IntergalacticMicrosystems/pico_v9k/hardware/rev2/v9k_dma_rev2.routed.png

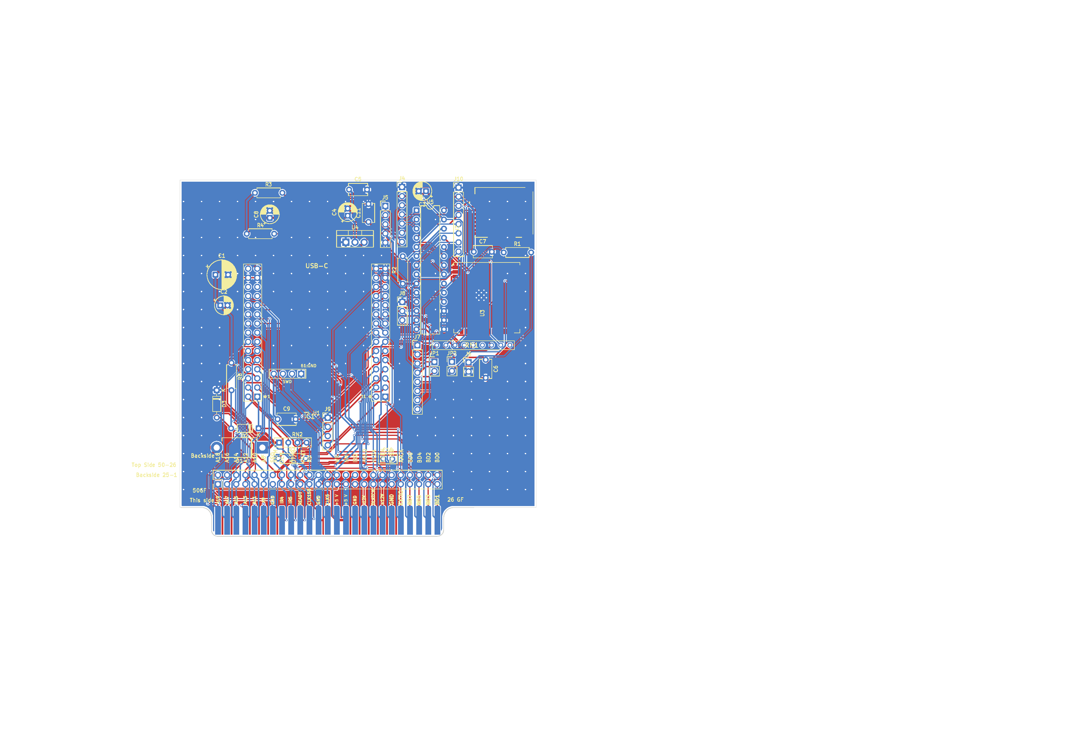
hardware/rev2/v9k_dma_rev2.routed.png
