IntergalacticMicrosystems/pico_v9k/hardware/rev2/v9k_dma_rev2.pdf

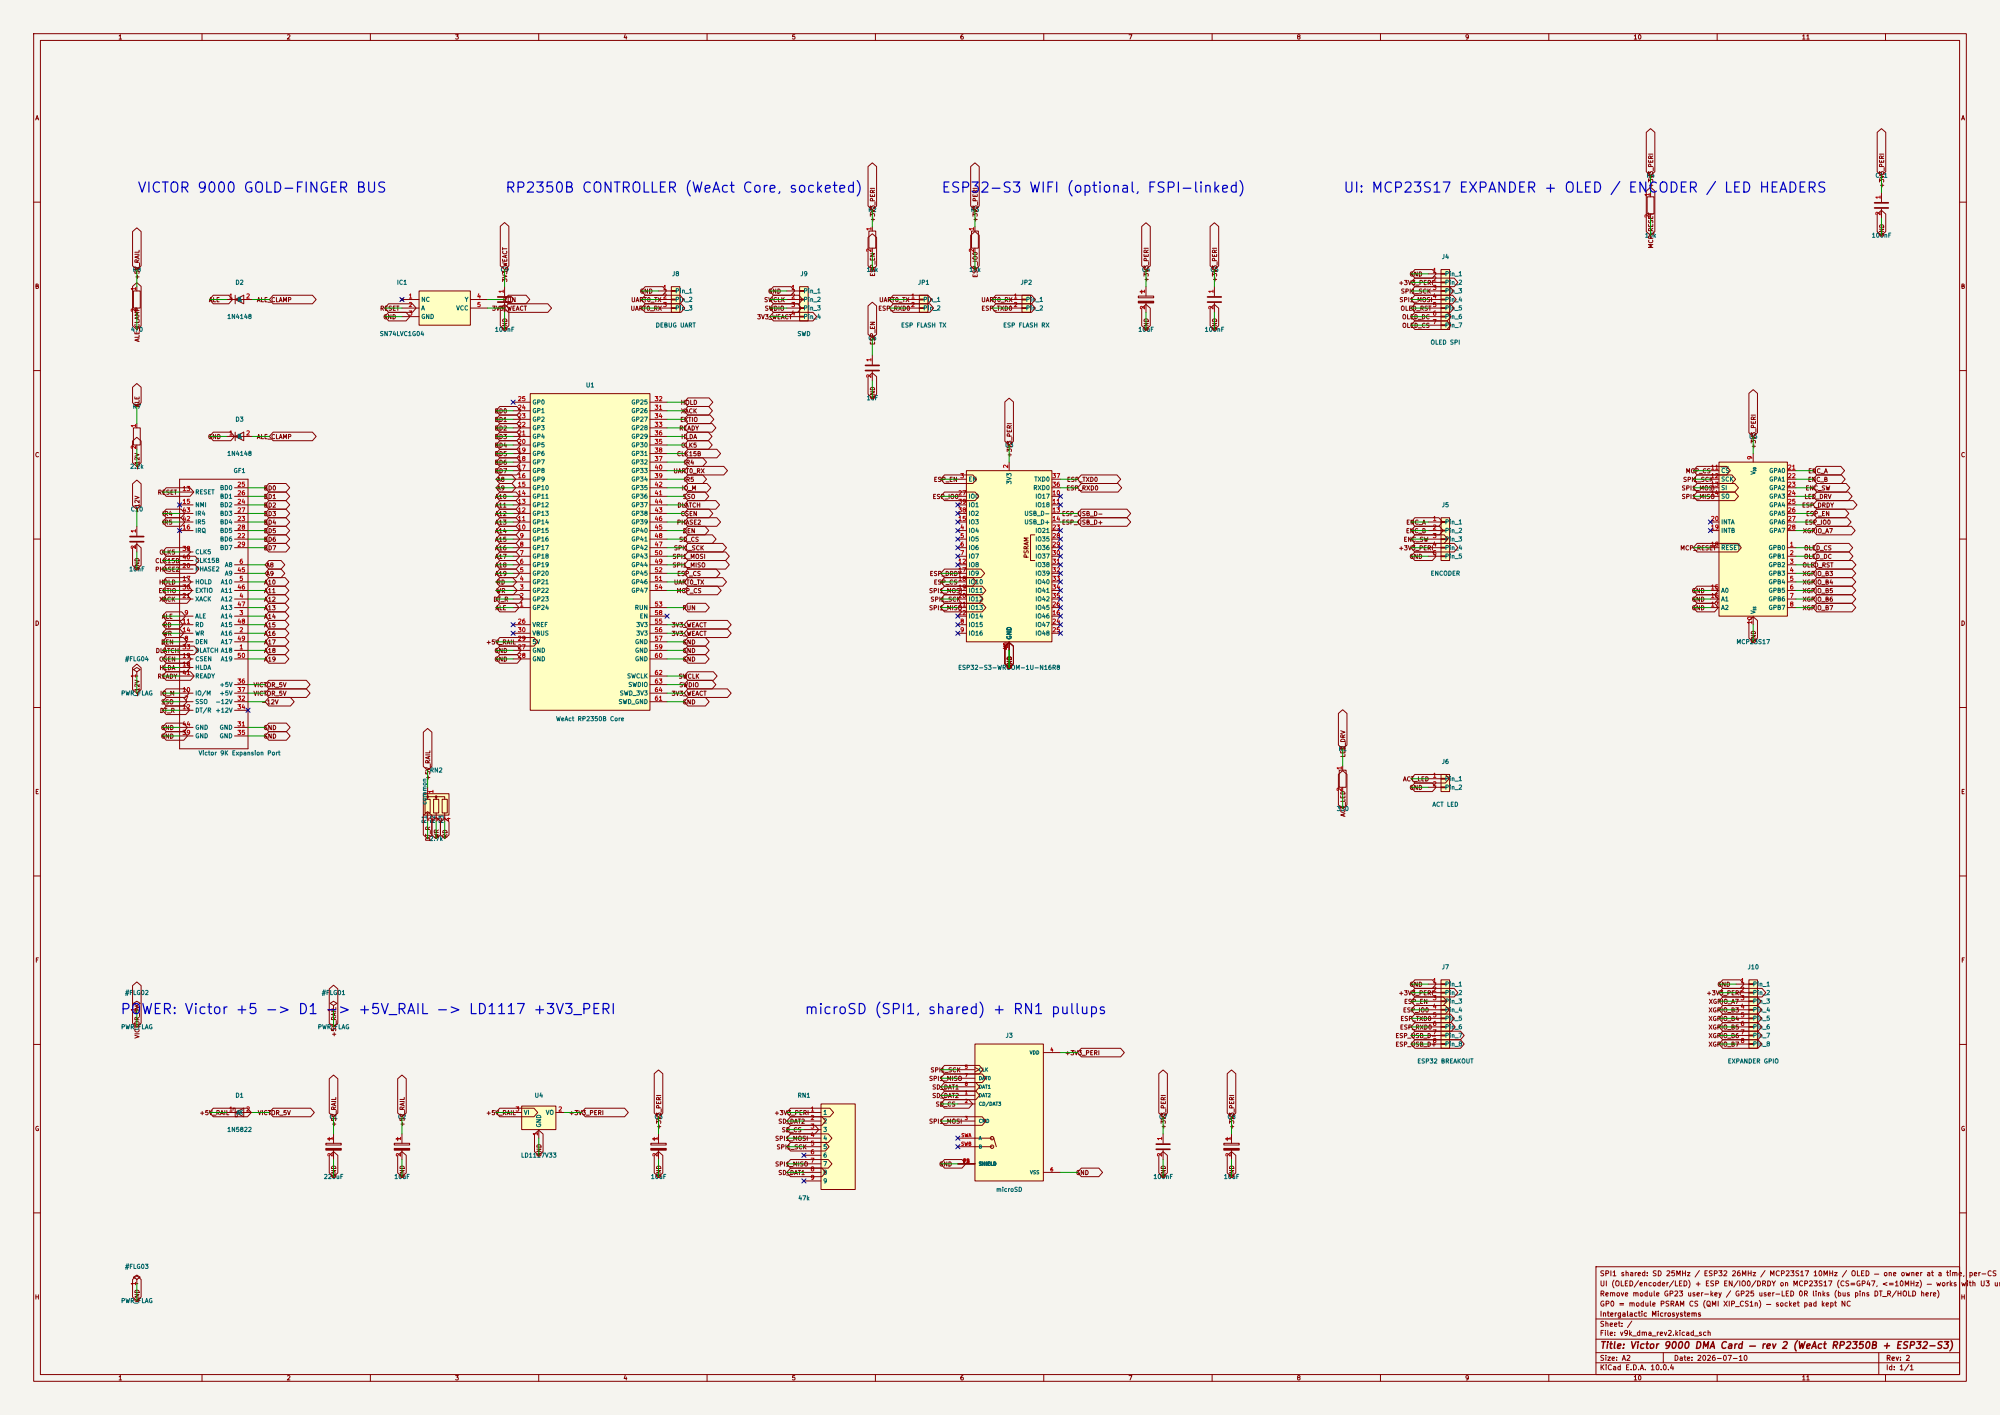
[picture p2: page 1]

IRQ 16 HOLD 17 HLDA 18 CSEN 19 PHASE2 20
HLDA READY PHASE2 CLK15B

SPI1 shared: SD 25MHz / ESP32 26MHz / MCP23S17 10MHz / OLED — one owner at a time, per-CS baud
Remove module GP23 user-key / GP25 user-LED 0R links (bus pins DT_R/HOLD here)
GP0 = module PSRAM CS (QMI XIP_CS1n) — socket pad kept NC
Intergalactic Microsystems
Sheet: /
File: v9k_dma_rev2.kicad_sch
Title: Victor 9000 DMA Card — rev 2 (WeAct RP2350B + ESP32-S3)

Size: A2 | Rev: 2
KiCad E.D.A. 10.0.4 | Id: 1/1
