IntergalacticMicrosystems/pico_v9k/hardware/rev2/v9k_dma_rev2.kicad_pcb

## KiCad design hardware/rev2/v9k_dma_rev2.kicad_pcb (2026-07-11)

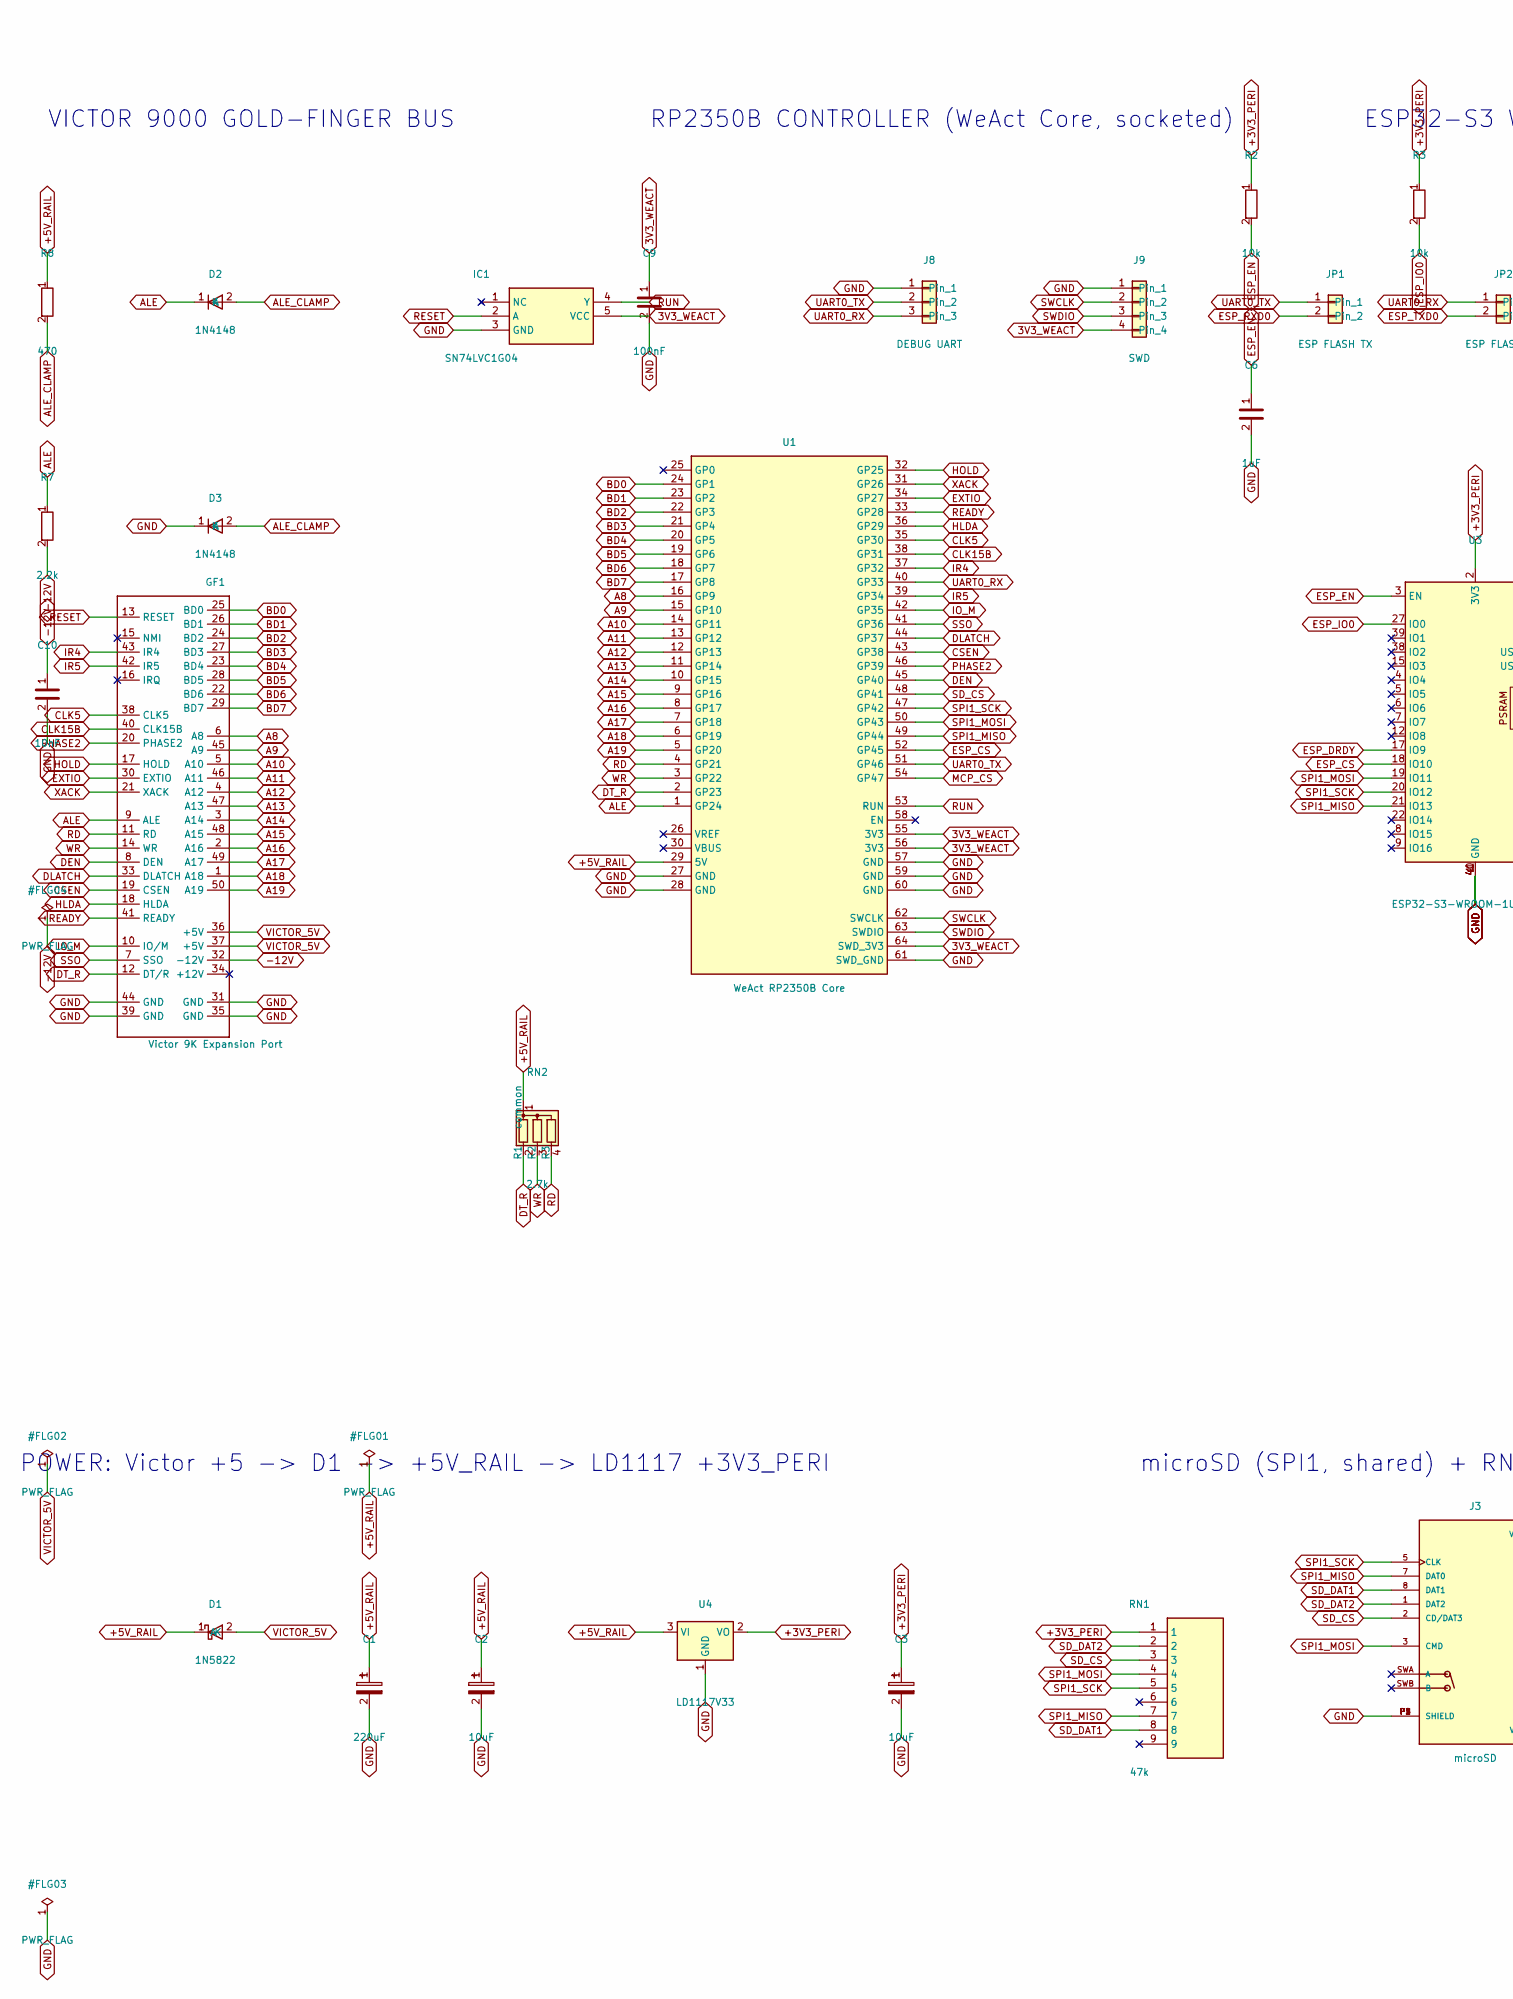
[picture p3: schematic v9k_dma_rev2.kicad_sch, Victor 9000 DMA Card — rev 2 (WeAct RP2350B + ESP32-S3), part in row 1, column 1]

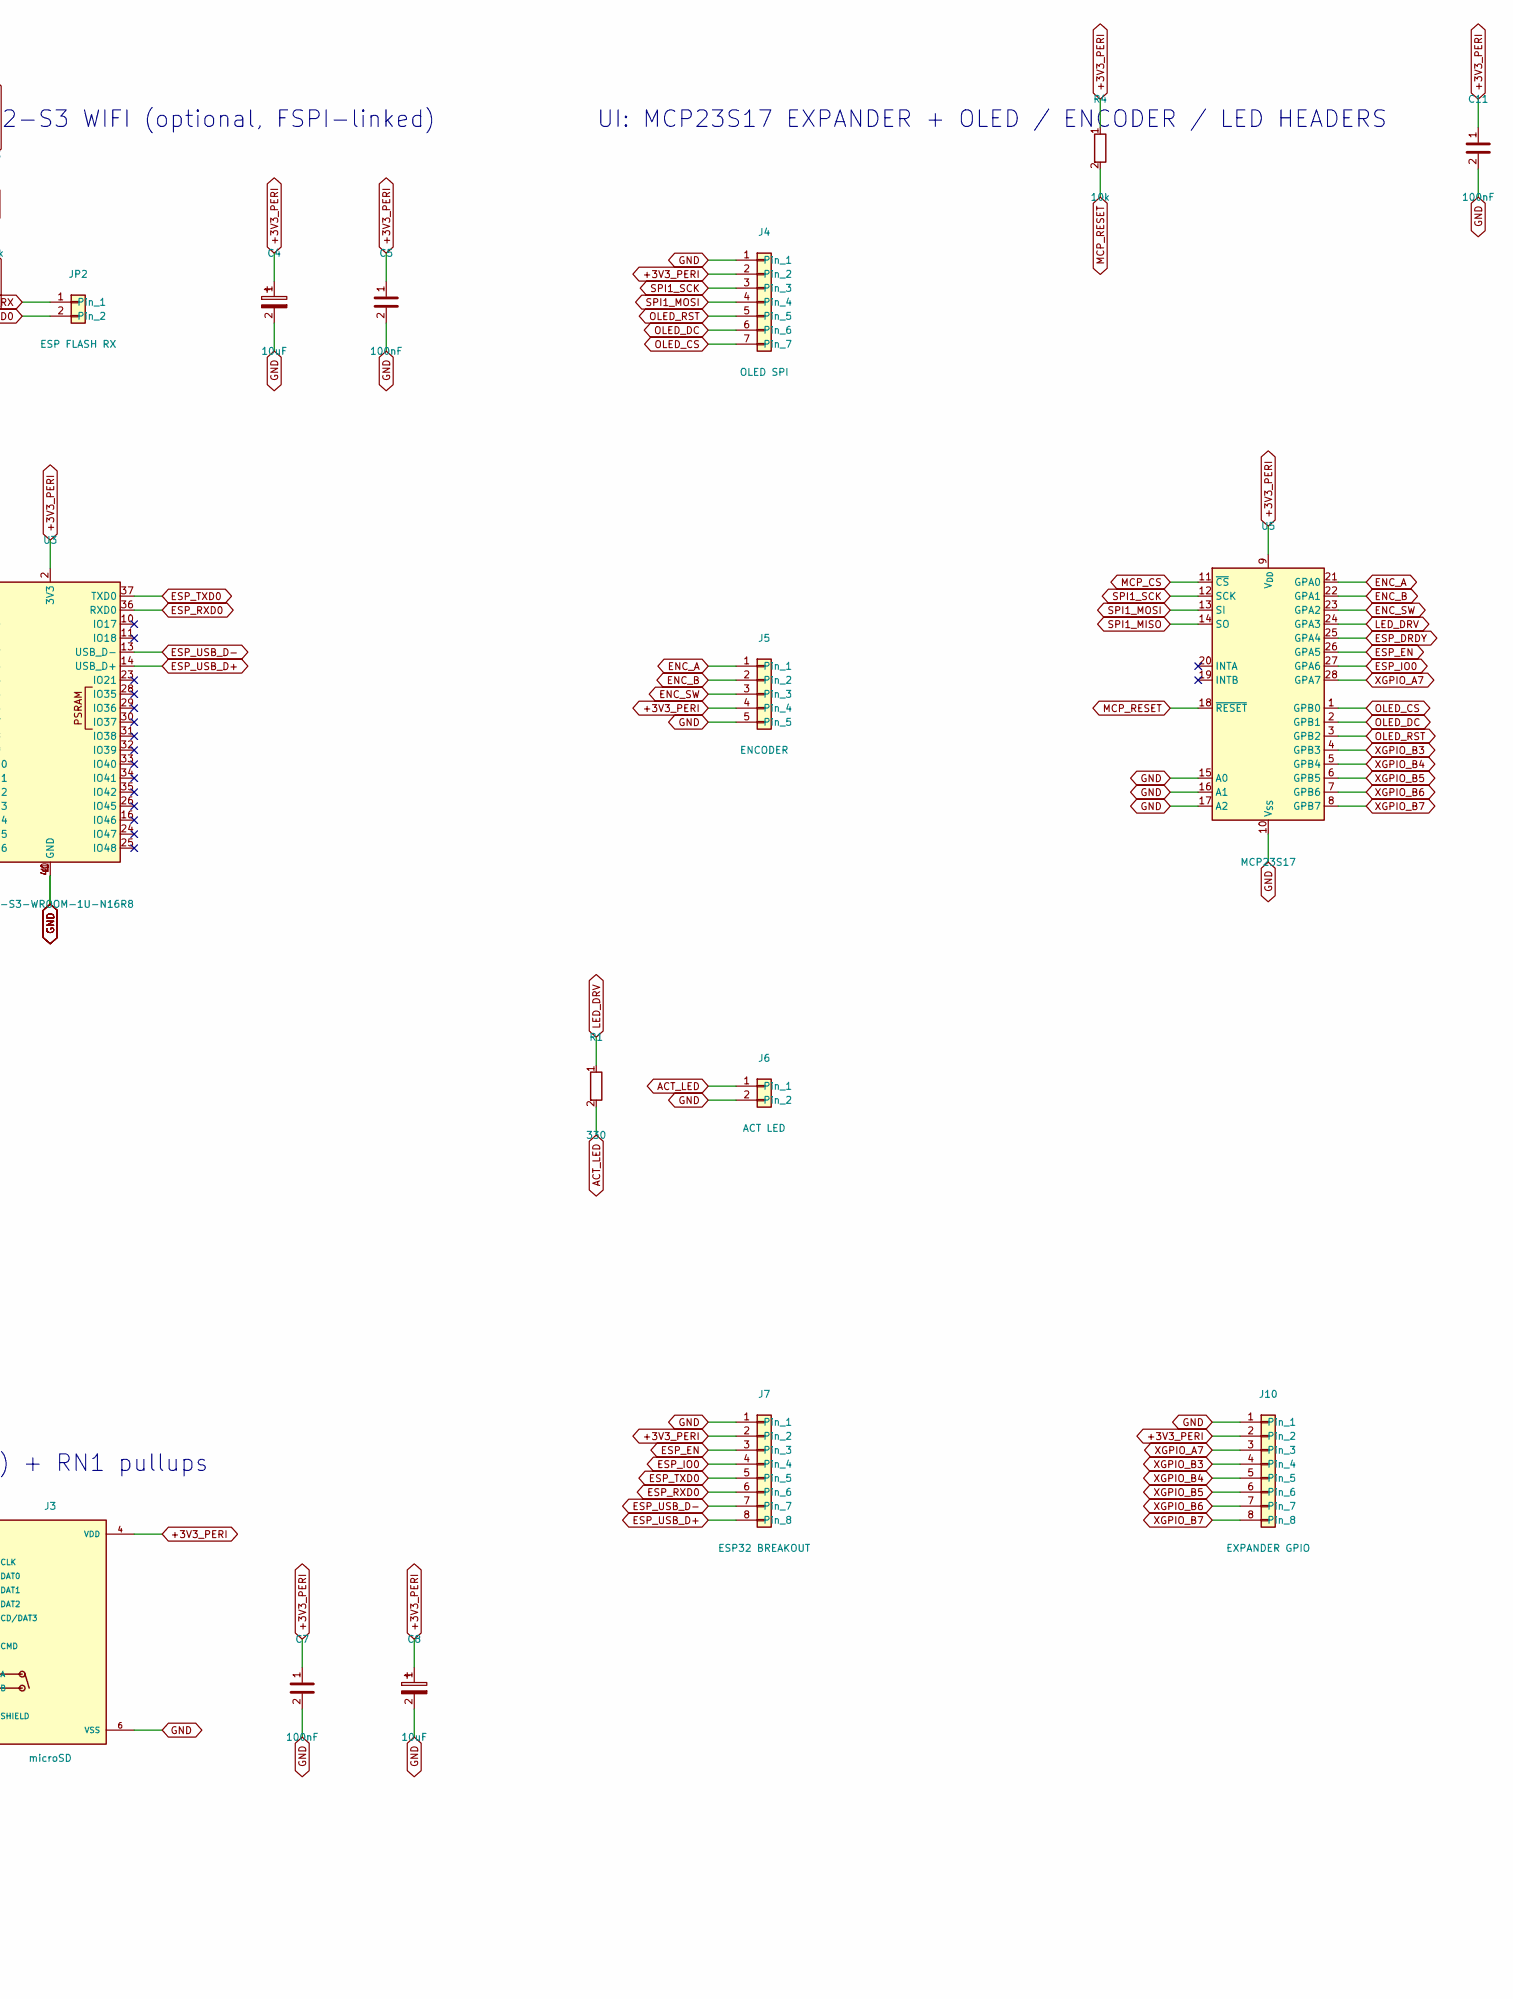
[picture p4: schematic v9k_dma_rev2.kicad_sch, Victor 9000 DMA Card — rev 2 (WeAct RP2350B + ESP32-S3), part in row 1, column 2]

Parts:
C1: 220uF; CP_Radial_D8.0mm_P3.50mm; MPN ESE227M025AG3AA
C2, C3, C4, C8: 10uF; CP_Radial_D5.0mm_P2.00mm; MPN 50YXJ10M5X11
C5, C7, C9, C11: 100nF; C_Disc_D5.1mm_W3.2mm_P5.00mm; MPN RD20B104K500A5HAND
C6: 1uF; C_Disc_D5.1mm_W3.2mm_P5.00mm; MPN SR305E105ZARTR1
C10: 10nF; C_Disc_D5.0mm_W2.5mm_P2.50mm; MPN C315C103K5R5TA
D1: 1N5822; D_DO-201AD_P12.70mm_Horizontal; MPN 1N5822-TP
D2, D3: 1N4148; D_DO-35_SOD27_P7.62mm_Horizontal; MPN 1N4148
GF1: Victor 9K Expansion Port; Victor_Gold_Fingers_3
IC1: SN74LVC1G04; SOT65P210X110-5N; MPN SN74LVC1G04DCKR
J3: microSD; HRS_DM3AT-SF-PEJM5; MPN DM3AT-SF-PEJM5
J4: OLED SPI; PinHeader_1x07_P2.54mm_Vertical; MPN PREC040SAAN-RC
J5: ENCODER; PinHeader_1x05_P2.54mm_Vertical; MPN PREC040SAAN-RC
J6: ACT LED; PinHeader_1x02_P2.54mm_Vertical; MPN PREC040SAAN-RC
J7: ESP32 BREAKOUT; PinHeader_1x08_P2.54mm_Vertical; MPN PREC040SAAN-RC
J8: DEBUG UART; PinHeader_1x03_P2.54mm_Vertical; MPN PREC040SAAN-RC
J9: SWD; PinHeader_1x04_P2.54mm_Vertical; MPN PREC040SAAN-RC
J10: EXPANDER GPIO; PinHeader_1x08_P2.54mm_Vertical; MPN PREC040SAAN-RC
JP1: ESP FLASH TX; PinHeader_1x02_P2.54mm_Vertical; MPN PREC040SAAN-RC
JP2: ESP FLASH RX; PinHeader_1x02_P2.54mm_Vertical; MPN PREC040SAAN-RC
R1: 330; R_Axial_DIN0207_L6.3mm_D2.5mm_P7.62mm_Horizontal; MPN RNMF14FTC330R
R2, R3, R4: 10k; R_Axial_DIN0207_L6.3mm_D2.5mm_P7.62mm_Horizontal; MPN MFR-25FRF52-10K
R7: 2.2k; R_Axial_DIN0207_L6.3mm_D2.5mm_P7.62mm_Horizontal; MPN MFR-25FTE52-2K2
R8: 470; R_Axial_DIN0207_L6.3mm_D2.5mm_P7.62mm_Horizontal; MPN MFR-25FTE52-470R
RN1: 47k; 4609X101473LF; MPN 4609X-101-473LF
RN2: 2.7k; R_Array_SIP4; MPN 4604X-101-272LF
U1: WeAct RP2350B Core; WeAct_RP2350B_Core_Socket; MPN WeAct RP2350B Core Board (16MB flash + 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
U3: ESP32-S3-WROOM-1U-N16R8; ESP32-S3-WROOM-1U; MPN ESP32-S3-WROOM-1U-N16R8
U4: LD1117V33; TO-220-3_Vertical; MPN LD1117V33
U5: MCP23S17; DIP-28_W7.62mm; MPN MCP23S17-E/SP

Connections:
3V3_WEACT: C9.1, IC1.5 (VCC), J9.4, U1.55 (3V3), U1.56 (3V3), U1.64 (SWD_3V3)
+3V3_PERI: C3.1, C4.1, C5.1, C7.1, C8.1, C11.1, J3.4 (VDD), J4.2, J5.4, J7.2, J10.2, R2.1, R3.1, R4.1, RN1.1, U3.2 (3V3), U4.2 (VO), U5.9 (V_{DD})
+5V_RAIL: C1.1, C2.1, D1.1 (K), R8.1, RN2.1 (common), U1.29 (5V), U4.3 (VI)
-12V: C10.1, GF1.32 (-12V), R7.2
A8: GF1.6 (A8), U1.16 (GP9)
A9: GF1.45 (A9), U1.15 (GP10)
A10: GF1.5 (A10), U1.14 (GP11)
A11: GF1.46 (A11), U1.13 (GP12)
A12: GF1.4 (A12), U1.12 (GP13)
A13: GF1.47 (A13), U1.11 (GP14)
A14: GF1.3 (A14), U1.10 (GP15)
A15: GF1.48 (A15), U1.9 (GP16)
A16: GF1.2 (A16), U1.8 (GP17)
A17: GF1.49 (A17), U1.7 (GP18)
A18: GF1.1 (A18), U1.6 (GP19)
A19: GF1.50 (A19), U1.5 (GP20)
ACT_LED: J6.1, R1.2
ALE: D2.1 (K), GF1.9 (ALE), R7.1, U1.1 (GP24)
ALE_CLAMP: D2.2 (A), D3.2 (A), R8.2
BD0: GF1.25 (BD0), U1.24 (GP1)
BD1: GF1.26 (BD1), U1.23 (GP2)
BD2: GF1.24 (BD2), U1.22 (GP3)
BD3: GF1.27 (BD3), U1.21 (GP4)
BD4: GF1.23 (BD4), U1.20 (GP5)
BD5: GF1.28 (BD5), U1.19 (GP6)
BD6: GF1.22 (BD6), U1.18 (GP7)
BD7: GF1.29 (BD7), U1.17 (GP8)
CLK5: GF1.38 (CLK5), U1.35 (GP30)
CLK15B: GF1.40 (CLK15B), U1.38 (GP31)
CSEN: GF1.19 (CSEN), U1.43 (GP38)
DEN: GF1.8 (DEN), U1.45 (GP40)
DLATCH: GF1.33 (DLATCH), U1.44 (GP37)
DT_R: GF1.12 (DT/R), RN2.2 (R1), U1.2 (GP23)
ENC_A: J5.1, U5.21 (GPA0)
ENC_B: J5.2, U5.22 (GPA1)
ENC_SW: J5.3, U5.23 (GPA2)
ESP_CS: U1.52 (GP45), U3.18 (IO10)
ESP_DRDY: U3.17 (IO9), U5.25 (GPA4)
ESP_EN: C6.1, J7.3, R2.2, U3.3 (EN), U5.26 (GPA5)
ESP_IO0: J7.4, R3.2, U3.27 (IO0), U5.27 (GPA6)
ESP_RXD0: J7.6, JP1.2, U3.36 (RXD0)
ESP_TXD0: J7.5, JP2.2, U3.37 (TXD0)
ESP_USB_D+: J7.8, U3.14 (USB_D+)
ESP_USB_D-: J7.7, U3.13 (USB_D-)
EXTIO: GF1.30 (EXTIO), U1.34 (GP27)
GND: C1.2, C2.2, C3.2, C4.2, C5.2, C6.2, C7.2, C8.2, C9.2, C10.2, C11.2, D3.1 (K), GF1.31 (GND), GF1.35 (GND), GF1.39 (GND), GF1.44 (GND), IC1.3 (GND), J3.6 (VSS), J3.P1 (SHIELD), J3.P2 (SHIELD), J3.P3 (SHIELD), J3.P4 (SHIELD), J4.1, J5.5, J6.2, J7.1, J8.1, J9.1, J10.1, U1.27 (GND), U1.28 (GND), U1.57 (GND), U1.59 (GND), U1.60 (GND), U1.61 (SWD_GND), U3.1 (GND), U3.40 (GND), U3.41 (GND), U4.1 (GND), U5.10 (V_{SS}), U5.15 (A0), U5.16 (A1), U5.17 (A2)
HLDA: GF1.18 (HLDA), U1.36 (GP29)
HOLD: GF1.17 (HOLD), U1.32 (GP25)
IO_M: GF1.10 (IO/M), U1.42 (GP35)
IR4: GF1.43 (IR4), U1.37 (GP32)
IR5: GF1.42 (IR5), U1.39 (GP34)
LED_DRV: R1.1, U5.24 (GPA3)
MCP_CS: U1.54 (GP47), U5.11 (~CS)
MCP_RESET: R4.2, U5.18 (~RESET)
OLED_CS: J4.7, U5.1 (GPB0)
OLED_DC: J4.6, U5.2 (GPB1)
OLED_RST: J4.5, U5.3 (GPB2)
PHASE2: GF1.20 (PHASE2), U1.46 (GP39)
RD: GF1.11 (RD), RN2.4 (R3), U1.4 (GP21)
READY: GF1.41 (READY), U1.33 (GP28)
RESET: GF1.13 (RESET), IC1.2 (A)
RUN: IC1.4 (Y), U1.53 (RUN)
SD_CS: J3.2 (CD/DAT3), RN1.3, U1.48 (GP41)
SD_DAT1: J3.8 (DAT1), RN1.8
SD_DAT2: J3.1 (DAT2), RN1.2
SPI1_MISO: J3.7 (DAT0), RN1.7, U1.49 (GP44), U3.21 (IO13), U5.14 (SO)
SPI1_MOSI: J3.3 (CMD), J4.4, RN1.4, U1.50 (GP43), U3.19 (IO11), U5.13 (SI)
SPI1_SCK: J3.5 (CLK), J4.3, RN1.5, U1.47 (GP42), U3.20 (IO12), U5.12 (SCK)
SSO: GF1.7 (SSO), U1.41 (GP36)
SWCLK: J9.2, U1.62 (SWCLK)
SWDIO: J9.3, U1.63 (SWDIO)
UART0_RX: J8.3, JP2.1, U1.40 (GP33)
UART0_TX: J8.2, JP1.1, U1.51 (GP46)
VICTOR_5V: D1.2 (A), GF1.36 (+5V), GF1.37 (+5V)
WR: GF1.14 (WR), RN2.3 (R2), U1.3 (GP22)
XACK: GF1.21 (XACK), U1.31 (GP26)
XGPIO_A7: J10.3, U5.28 (GPA7)
XGPIO_B3: J10.4, U5.4 (GPB3)
XGPIO_B4: J10.5, U5.5 (GPB4)
XGPIO_B5: J10.6, U5.6 (GPB5)
XGPIO_B6: J10.7, U5.7 (GPB6)
XGPIO_B7: J10.8, U5.8 (GPB7)

Notes on the sheet:
VICTOR 9000 GOLD-FINGER BUS
RP2350B CONTROLLER (WeAct Core, socketed)
ESP32-S3 WIFI (optional, FSPI-linked)
POWER: Victor +5 -> D1 -> +5V_RAIL -> LD1117 +3V3_PERI
microSD (SPI1, shared) + RN1 pullups
UI: MCP23S17 EXPANDER + OLED / ENCODER / LED HEADERS

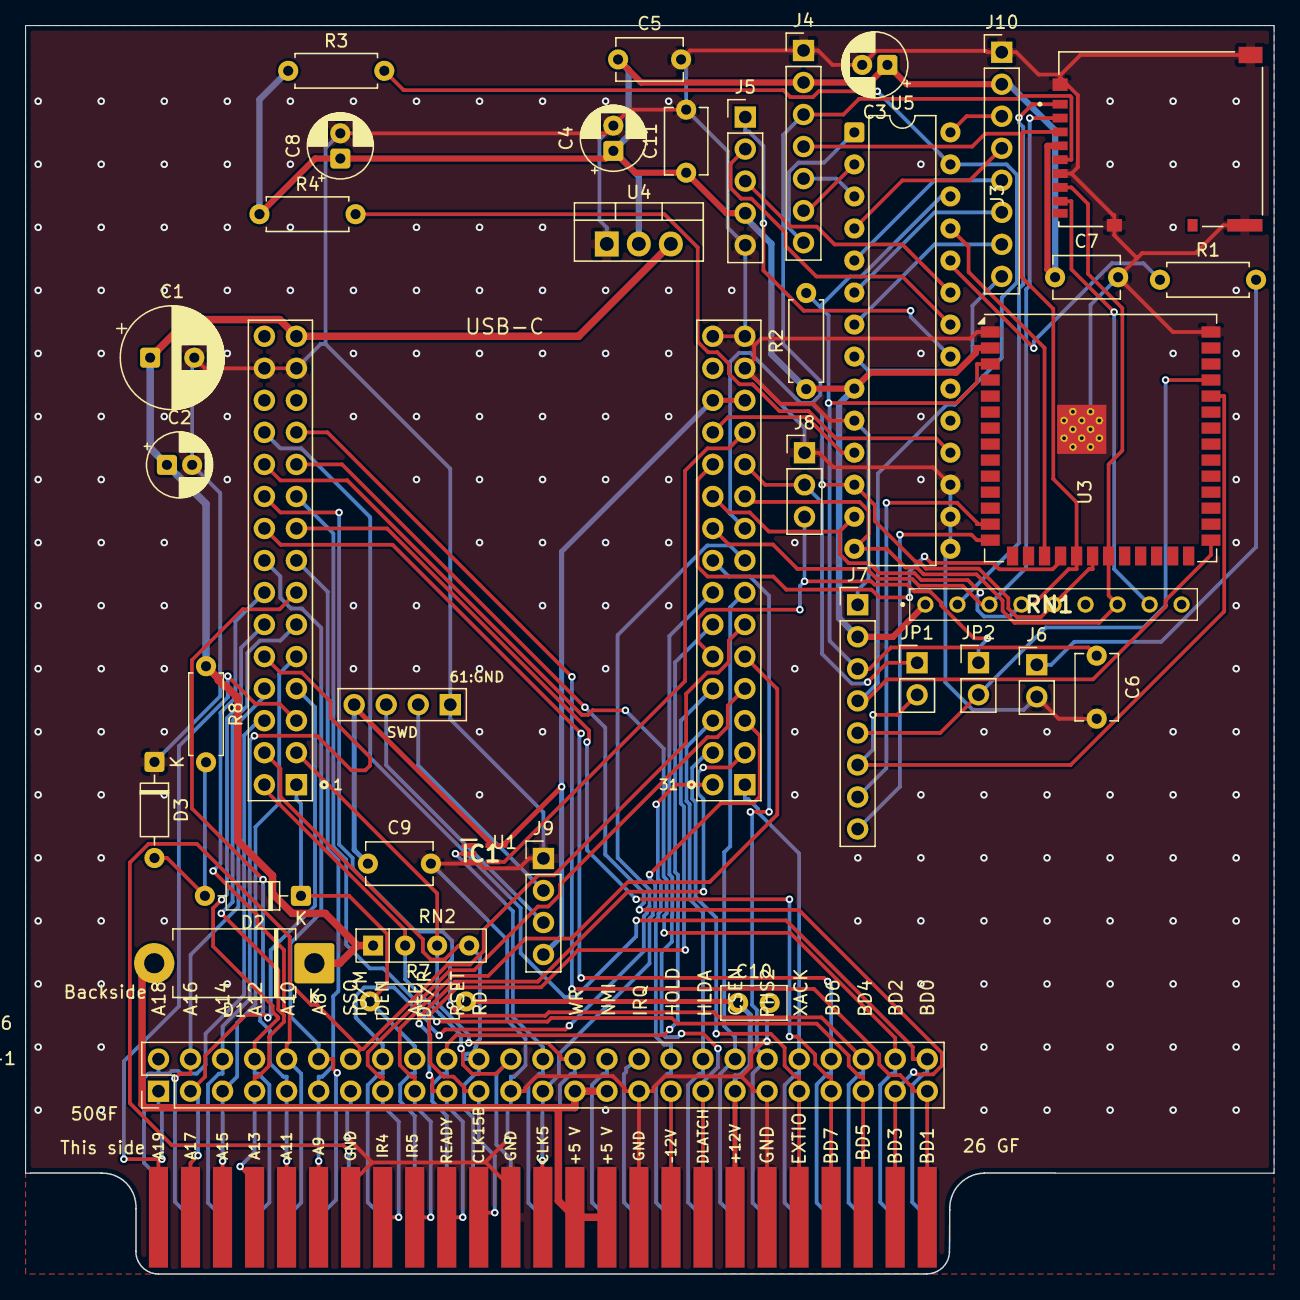
[picture p5: board v9k_dma_rev2.kicad_pcb from above]

Board: 2 copper layers, 99.0 x 99.0 mm, 38 parts (0 on the bottom side), 82 nets.
