IntergalacticMicrosystems/pico_v9k/hardware/Victor9K_pga2350.kicad_pcb

## KiCad design hardware/Victor9K_pga2350.kicad_pcb (2026-05-01)

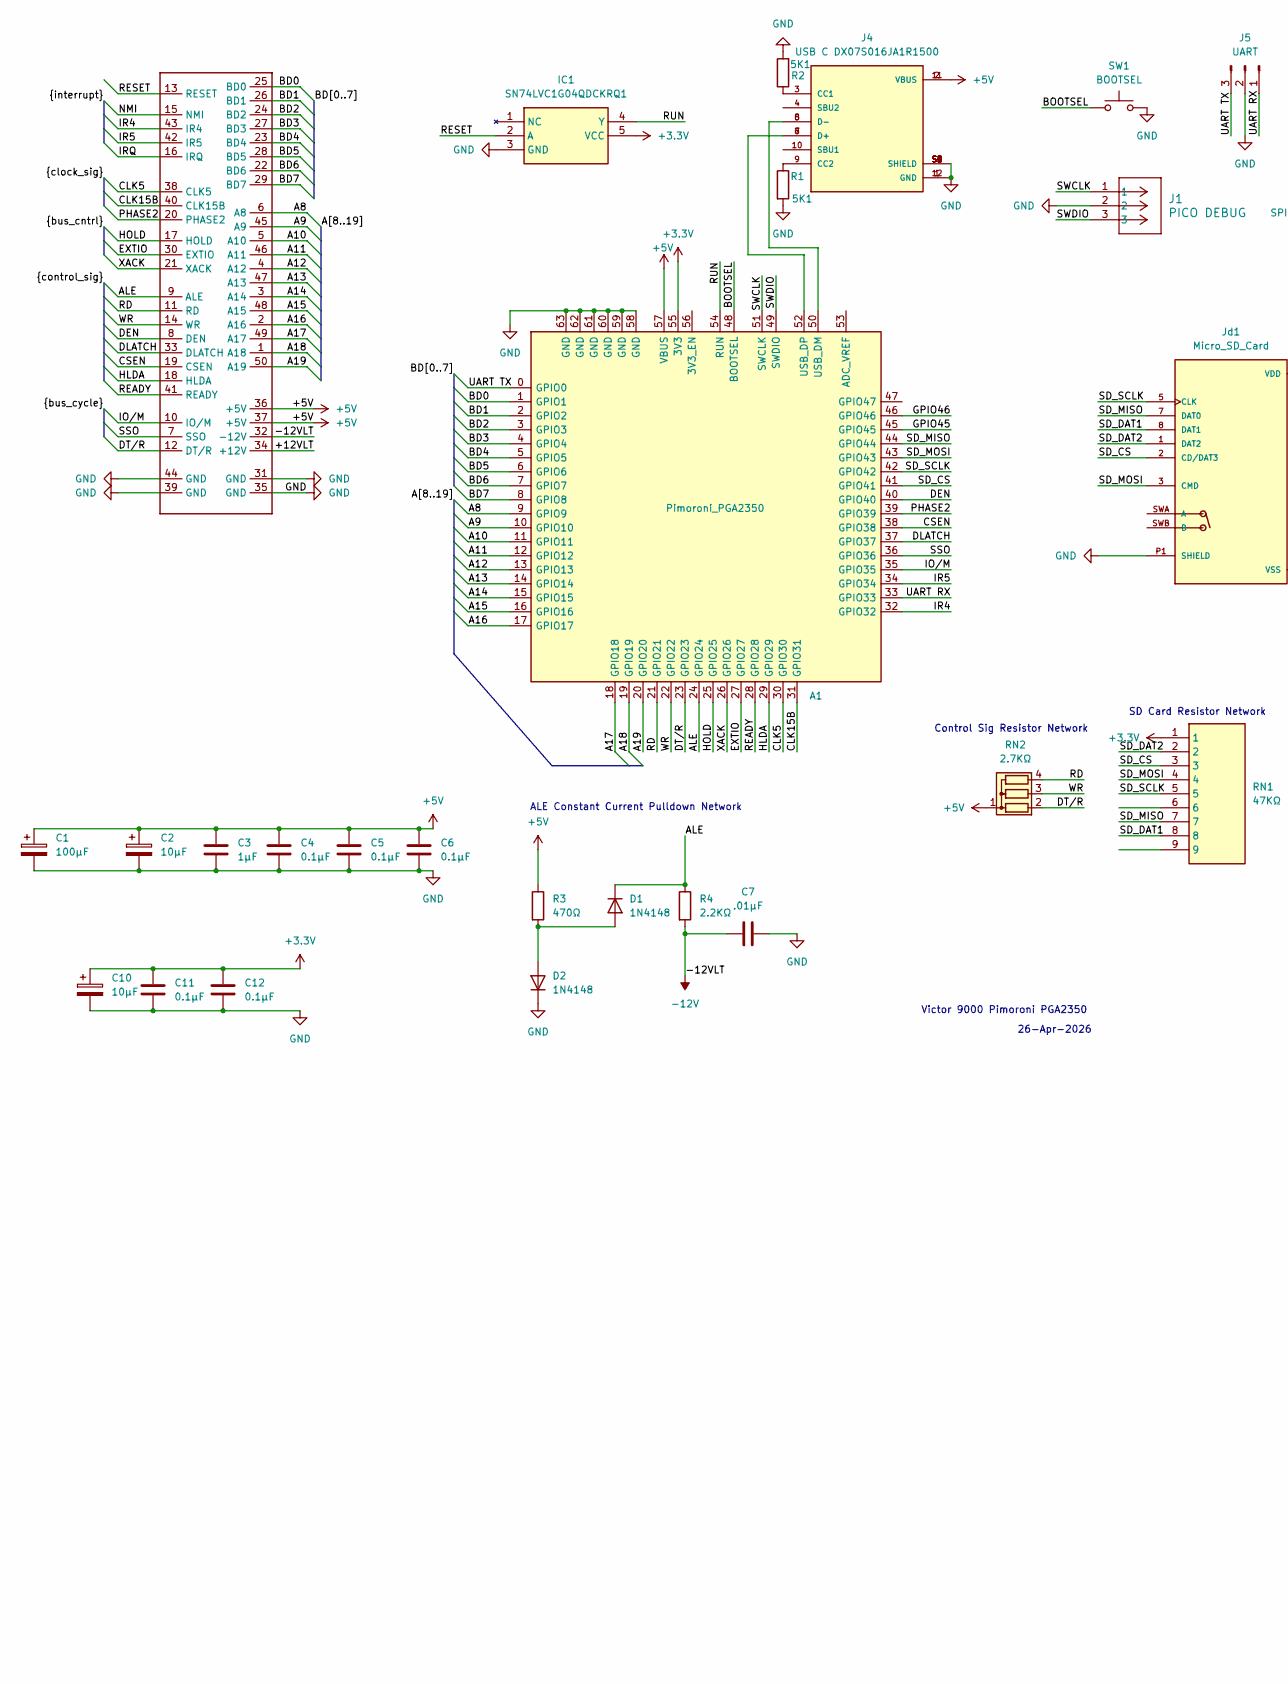
[picture p6: schematic Victor9K_pga2350.kicad_sch, part in row 1, column 1]

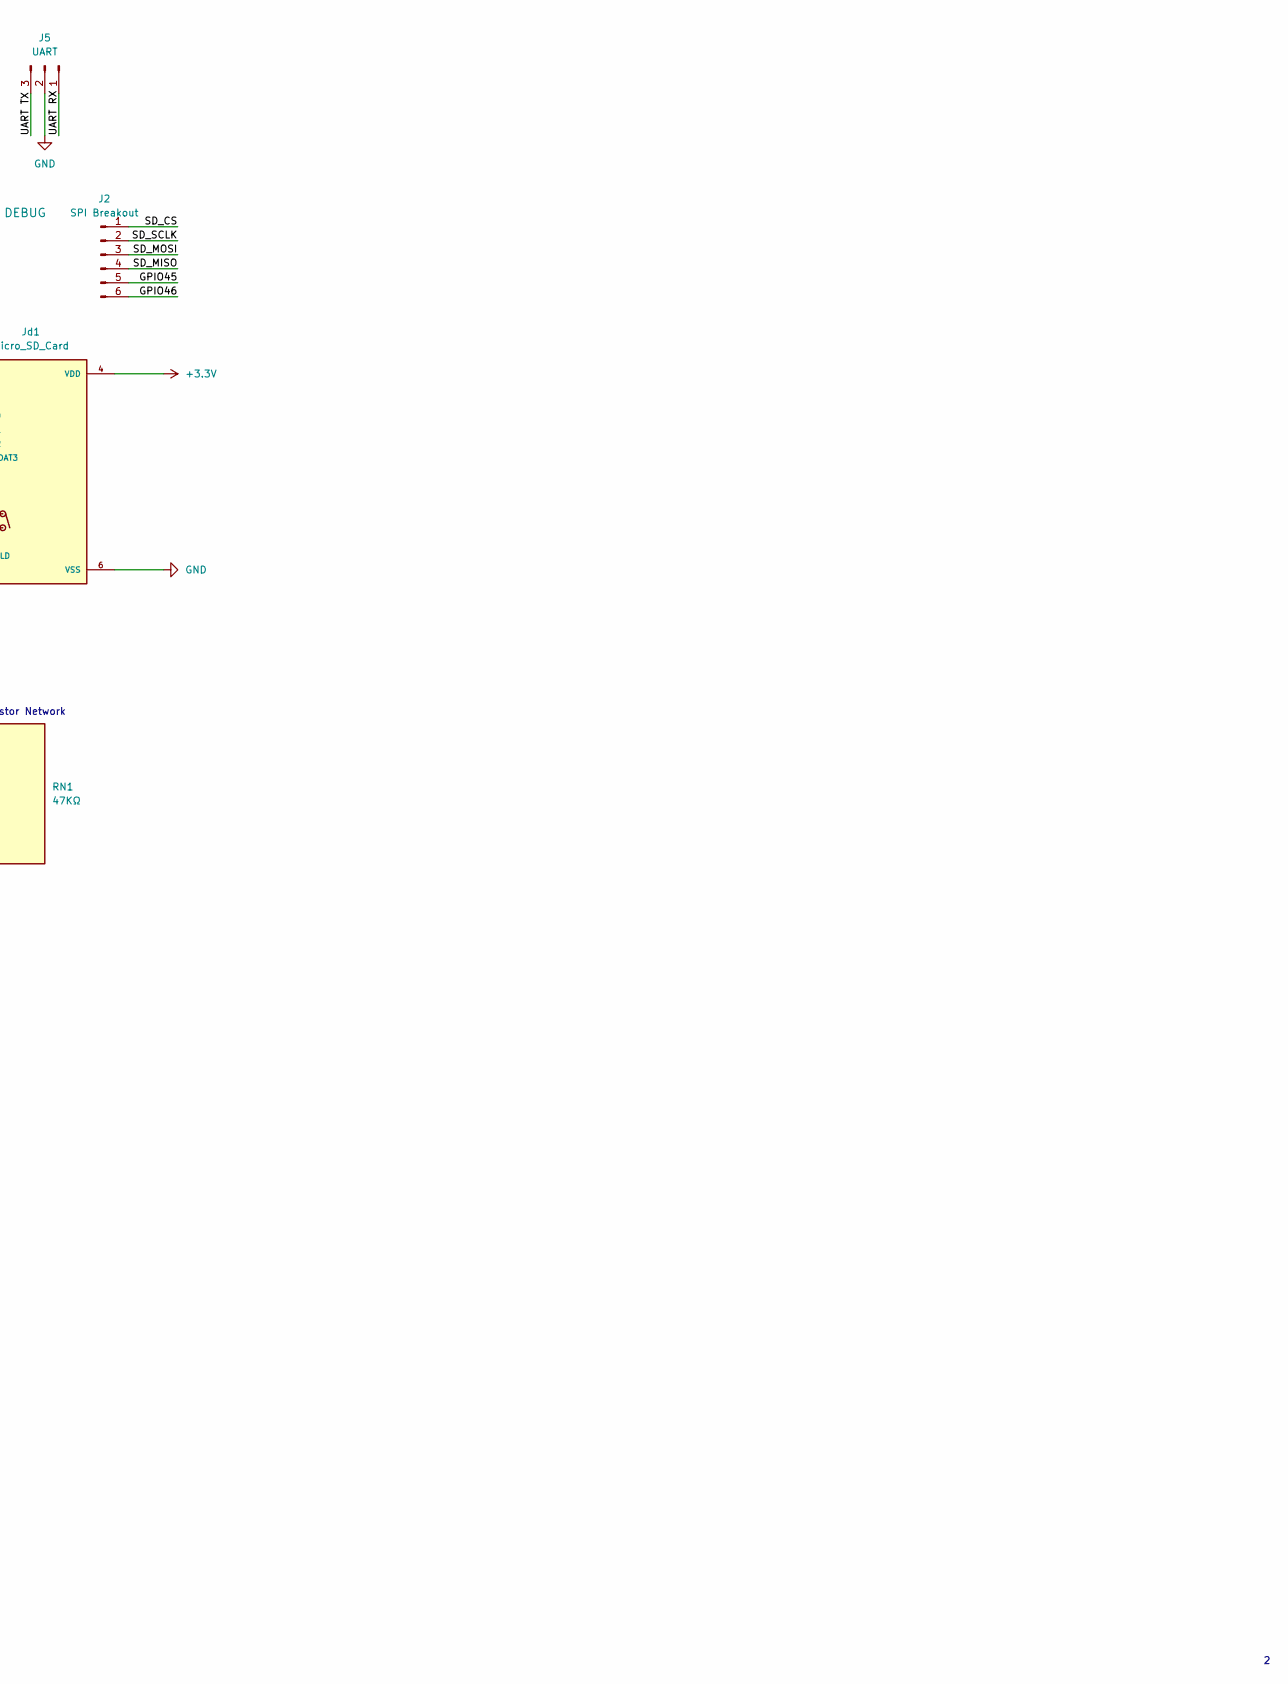
[picture p7: schematic Victor9K_pga2350.kicad_sch, part in row 1, column 2]

Parts:
A1: Pimoroni_PGA2350; pimoroni_pga2350
C1: 100µF; CP_Axial_L11.0mm_D8.0mm_P15.00mm_Horizontal
C2, C10: 10µF; C_Disc_D5.0mm_W2.5mm_P5.00mm
C3: 1µF; C_Disc_D5.0mm_W2.5mm_P5.00mm
C4, C5, C6, C11, C12: 0.1µF; C_Disc_D5.0mm_W2.5mm_P5.00mm
C7: .01µF; C_Disc_D5.0mm_W2.5mm_P5.00mm
D1, D2: 1N4148; D_DO-35_SOD27_P7.62mm_Horizontal
GF1: Victor 9K Expansion Port; Victor_Gold_Fingers_3
IC1: SN74LVC1G04QDCKRQ1; SOT65P210X110-5N; Mouser Part Number 595-SN74LVC1G04QDCQ1
J1: PICO DEBUG; CONN_BM03B-SRSS-TBLFSN_JST
J2: SPI Breakout; PinHeader_1x06_P2.54mm_Vertical
J4: USB C DX07S016JA1R1500; JAE_DX07S016JA1R1500; PARTREV 1; JLCPCB Part # C3197885
J5: UART; PinHeader_1x03_P2.54mm_Vertical
Jd1: Micro_SD_Card; HRS_DM3AT-SF-PEJM5; PARTREV 20200913
R1, R2: 5K1; R_Axial_DIN0204_L3.6mm_D1.6mm_P5.08mm_Horizontal
R3: 470Ω; R_Axial_DIN0204_L3.6mm_D1.6mm_P5.08mm_Horizontal
R4: 2.2KΩ; R_Axial_DIN0204_L3.6mm_D1.6mm_P5.08mm_Horizontal
RN1: 47KΩ; 4609X101473LF; Mouser Part Number 652-4609X-1LF-47K
RN2: 2.7KΩ; R_Array_SIP4
SW1: BOOTSEL; B3FS1010P

Connections:
+3.3V: A1.55 (3V3), C10.1, C11.1, C12.1, IC1.5 (VCC), Jd1.4 (VDD), RN1.1
+5V: A1.57 (VBUS), C1.1, C2.1, C3.1, C4.1, C5.1, C6.1, GF1.36 (+5V), GF1.37 (+5V), J4.2 (VBUS), J4.11 (VBUS), R3.1, RN2.1 (common)
-12V: C7.1, GF1.32 (-12V), R4.2
/+12VLT: GF1.34 (+12V)
/A8: A1.9 (GPIO9), GF1.6 (A8)
/A9: A1.10 (GPIO10), GF1.45 (A9)
/A10: A1.11 (GPIO11), GF1.5 (A10)
/A11: A1.12 (GPIO12), GF1.46 (A11)
/A12: A1.13 (GPIO13), GF1.4 (A12)
/A13: A1.14 (GPIO14), GF1.47 (A13)
/A14: A1.15 (GPIO15), GF1.3 (A14)
/A15: A1.16 (GPIO16), GF1.48 (A15)
/A16: A1.17 (GPIO17), GF1.2 (A16)
/A17: A1.18 (GPIO18), GF1.49 (A17)
/A18: A1.19 (GPIO19), GF1.1 (A18)
/A19: A1.20 (GPIO20), GF1.50 (A19)
/ALE: A1.24 (GPIO24), D1.1 (K), GF1.9 (ALE), R4.1
/BD0: A1.1 (GPIO1), GF1.25 (BD0)
/BD1: A1.2 (GPIO2), GF1.26 (BD1)
/BD2: A1.3 (GPIO3), GF1.24 (BD2)
/BD3: A1.4 (GPIO4), GF1.27 (BD3)
/BD4: A1.5 (GPIO5), GF1.23 (BD4)
/BD5: A1.6 (GPIO6), GF1.28 (BD5)
/BD6: A1.7 (GPIO7), GF1.22 (BD6)
/BD7: A1.8 (GPIO8), GF1.29 (BD7)
/BOOTSEL: A1.48 (BOOTSEL), SW1.1
/CLK5: A1.30 (GPIO30), GF1.38 (CLK5)
/CLK15B: A1.31 (GPIO31), GF1.40 (CLK15B)
/CSEN: A1.38 (GPIO38), GF1.19 (CSEN)
/DEN: A1.40 (GPIO40), GF1.8 (DEN)
/DLATCH: A1.37 (GPIO37), GF1.33 (DLATCH)
/DT/R: A1.23 (GPIO23), GF1.12 (DT/R), RN2.2 (R1)
/EXTIO: A1.27 (GPIO27), GF1.30 (EXTIO)
/GPIO45: A1.45 (GPIO45), J2.5
/GPIO46: A1.46 (GPIO46), J2.6
/HLDA: A1.29 (GPIO29), GF1.18 (HLDA)
/HOLD: A1.25 (GPIO25), GF1.17 (HOLD)
/IO/M: A1.35 (GPIO35), GF1.10 (IO/M)
/IR4: A1.32 (GPIO32), GF1.43 (IR4)
/IR5: A1.34 (GPIO34), GF1.42 (IR5)
/IRQ: GF1.16 (IRQ)
/NMI: GF1.15 (NMI)
/PHASE2: A1.39 (GPIO39), GF1.20 (PHASE2)
/RD: A1.21 (GPIO21), GF1.11 (RD), RN2.4 (R3)
/READY: A1.28 (GPIO28), GF1.41 (READY)
/RESET: GF1.13 (RESET), IC1.2 (A)
/RUN: A1.54 (RUN), IC1.4 (Y)
/SD_CS: A1.41 (GPIO41), J2.1, Jd1.2 (CD/DAT3), RN1.3
/SD_DAT1: Jd1.8 (DAT1), RN1.8
/SD_DAT2: Jd1.1 (DAT2), RN1.2
/SD_MISO: A1.44 (GPIO44), J2.4, Jd1.7 (DAT0), RN1.7
/SD_MOSI: A1.43 (GPIO43), J2.3, Jd1.3 (CMD), RN1.4
/SD_SCLK: A1.42 (GPIO42), J2.2, Jd1.5 (CLK), RN1.5
/SSO: A1.36 (GPIO36), GF1.7 (SSO)
/SWCLK: A1.51 (SWCLK), J1.1
/SWDIO: A1.49 (SWDIO), J1.3
/UART RX: A1.33 (GPIO33), J5.1
/UART TX: A1.0 (GPIO0), J5.3
/WR: A1.22 (GPIO22), GF1.14 (WR), RN2.3 (R2)
/XACK: A1.26 (GPIO26), GF1.21 (XACK)
GND: A1.58 (GND), A1.59 (GND), A1.60 (GND), A1.61 (GND), A1.62 (GND), A1.63 (GND), C1.2, C2.2, C3.2, C4.2, C5.2, C6.2, C7.2, C10.2, C11.2, C12.2, D2.1 (K), GF1.31 (GND), GF1.35 (GND), GF1.39 (GND), GF1.44 (GND), IC1.3 (GND), J1.2, J4.1 (GND), J4.12 (GND), J4.S1 (SHIELD), J4.S2 (SHIELD), J4.S3 (SHIELD), J4.S4 (SHIELD), J4.S5 (SHIELD), J4.S6 (SHIELD), J5.2, Jd1.6 (VSS), Jd1.P1 (SHIELD), Jd1.P2 (SHIELD), Jd1.P3 (SHIELD), Jd1.P4 (SHIELD), R1.2, R2.2, SW1.2
unnamed: A1.50 (USB_DM), J4.5 (D-), J4.8 (D-)
unnamed: A1.52 (USB_DP), J4.6 (D+), J4.7 (D+)
unnamed: D1.2 (A), D2.2 (A), R3.2
unnamed: J4.3 (CC1), R2.1
unnamed: J4.9 (CC2), R1.1

Notes on the sheet:
26-Apr-2026
Control Sig Resistor Network
SD Card Resistor Network
ALE Constant Current Pulldown Network
Victor 9000 Pimoroni PGA2350

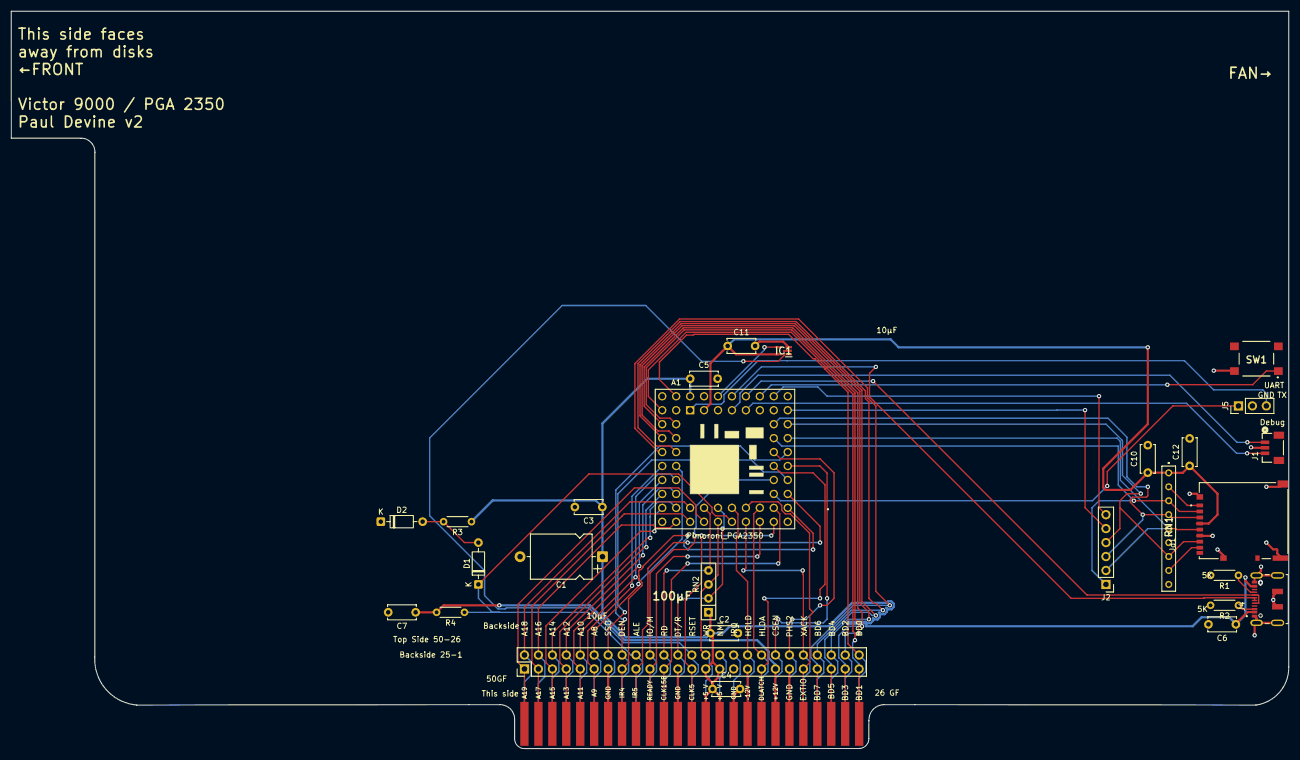
[picture p8: board Victor9K_pga2350.kicad_pcb from above]

Board: 4 copper layers, 232.7 x 134.3 mm, 27 parts (0 on the bottom side), 63 nets.
