IntergalacticMicrosystems/pico_v9k/software/pico_victor/dma.h

#ifndef DMA_VICTOR_H
#define DMA_VICTOR_H
#include <stdio.h>
#include "hardware/pio.h"

#define PIO_REGISTERS   pio0
#define REG_SM_CONTROL  0   

#define PIO_DMA_MASTER pio1
#define DMA_SM_CONTROL  0

#define ADDR_START_PIN 1 // DMA address output
#define LOWER_PIN_BASE 0
#define UPPER_PIN_BASE 16
#define DATA_SIZE 8
#define ADDRESS_BUS_SIZE 20
#define ADDRESS_AND_CONTROL_SIZE 31
#define ADDRESS_AND_DATA_SIZE 28
#define ADDRESS_DATA_CONBIT_SIZE 29  // 20-bit address, 8-bit data, 1-bit control
#define PIO_FULL_SIZE 32

#define DMA_BATCH_SIZE 128  // Number of bytes per DMA batch transfer
#define DMA_SHARE_WAIT_US 40   // Wait time after releasing bus before re-acquiring (in microseconds)
#define DMA_TIMEOUT_US 2000  // Timeout for DMA master acquisition (in microseconds)

#define BD0_PIN 1
#define A19_PIN 20
#define RD_PIN 21
#define WR_PIN 22
#define DTR_PIN 23       
#define ALE_PIN 24      
#define HOLD_PIN 25
#define XACK_PIN 26
#define EXTIO_PIN 27
#define READY_PIN 28
#define HLDA_PIN 29
#define CLOCK_5_PIN 30
#define CLOCK_15B_PIN 31
#define IR_4_PIN 32
#define UART_RX_PIN 33
#define IR_5_PIN 34
#define IO_M_PIN 35

// DMA board IRQ line (IR4 by default; jumperable to IR5 per manual).
#define DMA_IRQ_PIN IR_4_PIN
#define DMA_IRQ_ASSERT_LEVEL 1
#define DMA_IRQ_DEASSERT_LEVEL 0
#define SSO_PIN 36
#define DLATCH_PIN 37
#define CSEN_PIN 38
#define PHASE_2_PIN 39
#define DEN_PIN 40

// SD card SPI interface pins (hardware SPI1 on RP2350)
#define SD_CS_PIN   41  // Manual GPIO chip select -> SD DAT3/CS
#define SD_SCK_PIN  42  // SPI1_SCK              -> SD CLK
#define SD_MOSI_PIN 43  // SPI1_TX               -> SD CMD/DI
#define SD_MISO_PIN 44  // SPI1_RX               -> SD DAT0/DO
// GPIO 45, 46 are now free

#define UART_TX_PIN 0
#define UART_RX_PIN_NUM 33  // UART RX pin (shared with IR_5 alternate use)

// UART configuration (shared across files)
// UART0 carries the diag/log stream only; the interactive console moved to the
// USB CDC micro_tui REPL/menu (see console/tui.c). 115200 8N1.
#define UART_ID uart0
#define BAUD_RATE 115200

#define ADDRESS_DIR_PINCNT 2
#define DMA_READ 1
#define DMA_WRITE 0

// Extract target ID from SASI selection byte (bit mask format)
// In SASI selection, the data byte is a bit mask where each bit represents an ID:
// - Bit 7 (0x80) = Initiator (typically ID 7)
// - Bits 0-6 = Target IDs (one bit set for the selected target)
// Example: 0x81 = initiator 7 + target 0, 0x82 = initiator 7 + target 1
static inline uint8_t sasi_extract_target_id(uint8_t selection_byte) {
    uint8_t target_mask = selection_byte & 0x7F;  // Remove initiator bit (bit 7)
    if (target_mask == 0) return 0;
    // Find lowest set bit (target ID) using builtin
    return (uint8_t)__builtin_ctz(target_mask);
}

// FIFO operation types, defines for the 2-bit pio payload type flag
#define FIFO_REG_PREFETCH    0x00
#define FIFO_REG_READ_COMMIT 0x01
#define FIFO_REG_WRITE       0x02

#define FIFO_DMA_READ        0x00
#define FIFO_DMA_WRITE       0x01

static inline uint32_t fifo_payload_type(uint32_t raw_value) {
    // PIO encoding varies by operation type, but payload-type identifier is always in bits 31-30
    return (raw_value >> 30) & 0x03u;  // Write: type in bits 31-30
}

static inline uint32_t board_fifo_read_address(uint32_t raw_value) {
    return (raw_value >> 10) & 0xFFFFFu;  // Address is in bits 29-10 (board_registers uses right-shift ISR)
}

static inline uint32_t dma_fifo_write_address(uint32_t raw_value) {
    return (raw_value >> 2) & 0xFFFFFu;  // Write address is in bits 21-2 (ISR restored at line 66, then shifts by 10)
}

static inline uint8_t dma_fifo_write_data(uint32_t raw_value) {
    return (raw_value >> 22) & 0xFFu;  // Write data is in bits 29-22
}

static inline uint32_t dma_mask_offset(uint32_t offset) {
    if (offset >= 0x80) {
        return offset & ~0x1Fu;
    }
    return offset & ~0x0Fu;
}

static inline uint32_t board_fifo_encode_read(uint32_t address) {
    return ((address & 0xFFFFFu) << 10) | ((uint32_t) FIFO_REG_READ_COMMIT << 30);
}

static inline uint32_t dma_fifo_encode_write(uint32_t address, uint8_t data) {
    return ((address & 0xFFFFFu) << 2) |       // Address in bits 21-2
           (((uint32_t)data & 0xFFu) << 22) |  // Data in bits 29-22
           ((uint32_t)FIFO_REG_WRITE << 30); // Type in bits 31-30
}


// DMA operations use a TWO-WORD FIFO protocol (see dma_read_write.pio for details):
//
// WRITE: pio_sm_put(pio, sm, (addr << 1) | 1);        // Word 1: address + write flag
//        pio_sm_put(pio, sm, (addr & 0xFFF00) | data); // Word 2: A8-A19 + data byte
//
// READ:  pio_sm_put(pio, sm, (addr << 1) | 0);        // Word 1: address + read flag
//        pio_sm_put(pio, sm, 0xFFF00);                 // Word 2: pindirs control

#define DMA_REGISTER_BASE 0xEF300
#define DMA_REGISTER_BITMASK 0x00000EF3  //the top 12 bits for the PIO instance to match address against
#define DMA_BUS_START_POSITION (0xDF6 & 0xFFF)  // Sets up the BUS CONTROL pins to start DMA transfers
#define DMA_READ_START_POSITION (0xDF6 & 0xFFF)  // Sets up the BUS CONTROL pins to start DMA transfers
#define DMA_READ_T2_PINDIRS 0xFFF00 // Sets up the Address pins so [A19-A8] are outputs FFF, [BD7-BD0] 00 data pins are inputs
#define DMA_WRITE_T2_PINDIRS 0x07FFFFFF //Sets up the address and DMA control pins so 0-27 are outputs, 28-31 are inputs

// Convert SM number to the corresponding IRQ source
static const enum pio_interrupt_source fifo_sources[] = {
    pis_sm0_rx_fifo_not_empty,
    pis_sm1_rx_fifo_not_empty, 
    pis_sm2_rx_fifo_not_empty,
    pis_sm3_rx_fifo_not_empty
};

#pragma pack(push, 1)
typedef struct {
    // Control register (write-only)
    uint8_t control;

    // Command/Status register (read/write)
    uint8_t command;
    // NOTE: volatile required - written by Core 1 (sasi_enter_status_phase),
    // read by Core 0 ISR (status phase DATA prefetch)
    volatile uint8_t status;

    // Bus status register emulation (read-only)
    struct {
        uint8_t REQ : 1;
        uint8_t BSY : 1;
        uint8_t C_D : 1;
        uint8_t I_O : 1;
        uint8_t MSG : 1;
        uint8_t reserved : 3;
    } bus;

    // DMA address registers (3 bytes, written by CPU)
    union {
        struct {
            uint8_t low;   // hddmal
            uint8_t mid;   // hddmam
            uint8_t high;  // hddmah
        } bytes;
        uint32_t full;     // Internal Pico usage
    } dma_address;

    // Block count (as passed by LRB)
    union {
        struct {
            uint8_t low;
            uint8_t high;
        } bytes;
        uint16_t full;
    } block_count;

    // Logical Block Address (sector number)
    union {
        struct {
            uint8_t b0;
            uint8_t b1;
            uint8_t b2;
            uint8_t b3;
        } bytes;
        uint32_t full;
    } logical_block;

    // Optional data buffer (e.g., for load params or sense commands)
    struct {
        uint8_t data[16];
        uint8_t index;
        uint8_t length;
    } buffer;

    // Internal state flags (not exposed to CPU)
    // NOTE: Keep these as separate volatile bytes (not bitfields). Bitfields cause
    // read-modify-write collisions between fast IRQ paths and deferred processing.
    volatile struct {
        uint8_t dma_enabled;
        uint8_t dma_strobe;
        uint8_t dma_dir_in;          // 1 = device -> RAM (read), 0 = RAM -> device
        uint8_t interrupt_pending;
        uint8_t asserting_ack;
        uint8_t non_dma_req;
        uint8_t status_pending;      // 1 = waiting for host to read status byte
        uint8_t data_out_expected;   // Non-zero = expecting this many data-out bytes (e.g., for 0x0C params)
    } state;

    // Set by Core 0 ISR when a RESET write is detected on the control register.
    // Checked by Core 1 command loops to abort long-running commands promptly.
    volatile bool reset_requested;

    // SASI bus control state (tracks bus signals for status register)
    // NOTE: volatile required - accessed by both Core 0 (fast handler) and Core 1 (deferred processor)
    volatile uint8_t bus_ctrl;

    // Selected SASI target ID (from data bus during selection)
    // NOTE: volatile - written by Core 1 (defer processor), read cross-core
    volatile uint8_t selected_target;
} dma_registers_t;
#pragma pack(pop)

// Register offsets
typedef enum {
    REG_CONTROL = 0x00,
    REG_DATA    = 0x10,
    REG_STATUS  = 0x20, 
    REG_ADDR_L  = 0x80,
    REG_ADDR_M  = 0xA0,
    REG_ADDR_H  = 0xC0
} dma_reg_offsets_t;

// Control register bits
typedef enum {
    DMA_ON_VALUE_BIT = 0x01,  // Matches BIT_DMA_Enable (enable value latched by strobe)
    DMA_LOCKOUT_BIT  = 0x02,  // Matches BIT_CPU_Lockout
    DMA_ON_LATCH_BIT = 0x04,  // Matches BIT_DMA_Strobe latch pulse
    DMA_WR_MODE_BIT  = 0x08,  // Matches BIT_DMA_Dir (1 = device -> host)
    DMA_SELECT_BIT   = 0x10,  // Matches BIT_Select (assert SEL/)
    DMA_RESET_BIT    = 0x20   // Matches BIT_Reset
} dma_control_bits_t;

// SASI bus state bits (for internal state tracking)
typedef enum {
    SASI_INP_BIT = 0x01,
    SASI_CTL_BIT = 0x02,
    SASI_BSY_BIT = 0x04,
    SASI_REQ_BIT = 0x08,
    SASI_MSG_BIT = 0x10,
    SASI_SEL_BIT = 0x20,
    SASI_ACK_BIT = 0x40
} sasi_status_bits_t;

void one_time_pin_setup();
void debug_dump_pin(uint pin);
void pio_debug_state();
void core1_main();
void setup_bus_control();
// Global DMA registers — lives in scratch_x RAM for contention-free Core 1 access.
extern dma_registers_t dma_registers;
bool dma_write_to_victor_ram(uint8_t *data, size_t length, uint32_t start_address);
bool dma_read_from_victor_ram(uint8_t *data, size_t length, uint32_t start_address);
void dma_process_deferred_events(void);
void dma_process_deferred_events_cached(void);

// Store the board_registers program offset for reset_register_pio_sm()
void dma_set_board_reg_program_offset(int offset);

// Safely restart the register PIO SM (clears FIFOs, releases XACK/EXTIO, jumps to wrap_target)
void reset_register_pio_sm(void);

// Hold/release the Victor 8088 bus via HOLD/HLDA handshake (without PIO)
bool hold_victor_bus(void);
void release_victor_bus(void);

void dma_write_register(dma_registers_t *dma, dma_reg_offsets_t offset, uint8_t value);
uint8_t dma_read_register(dma_registers_t *dma, dma_reg_offsets_t offset);
void dma_device_reset(dma_registers_t *dma);
void dma_update_interrupts(dma_registers_t *dma, bool irq_state);
void dma_handle_sasi_req(dma_registers_t *dma);

// DMA read IRQ control - enable when DMA is active, disable when idle
void enable_dma_read_irq(void);
void disable_dma_read_irq(void);


#if VERIFY_DMA_WRITES
typedef struct {
    uint32_t sectors_checked;
    uint32_t sectors_failed;
    uint32_t total_byte_mismatches;
    bool first_error_recorded;
    uint32_t first_err_lba;
    uint32_t first_err_addr;
    uint16_t first_err_offset;
    uint8_t first_err_expected;
    uint8_t first_err_actual;
} dma_verify_stats_t;

extern dma_verify_stats_t dma_verify_stats;

// Read back data from Victor RAM and compare byte-by-byte against expected.
// Returns number of mismatching bytes, or -1 if the DMA read-back itself failed.
int dma_verify_victor_ram(uint32_t victor_addr, const uint8_t *expected, uint32_t len, uint32_t lba);
#endif

#ifdef UNIT_TEST
uint8_t* test_get_victor_ram();
size_t test_get_victor_ram_size();
#endif

#endif // DMA_VICTOR_H
