IntergalacticMicrosystems/pico_v9k/software/pico_victor/dma.c

#include "pico/stdlib.h"
#include "hardware/pio.h"
#include "hardware/dma.h"
#include "hardware/structs/systick.h"
#include "hardware/structs/iobank0.h"
#include "hardware/structs/padsbank0.h"
#include <stdio.h>
#include <stdlib.h>
#include <stdint.h>
#include <string.h>
#include "hardware/sync.h"
#include "dma.h"
#include "register_irq_handlers.h"
#include "board_registers.pio.h"
#include "sasi.h"
#include "sasi_log.h"
#include "logging.h"
#include "reg_queue_processor.h"
#include "fifo_helpers.h"

// Set to 1 to enable debug printf during DMA operations (WARNING: breaks timing-critical bus operations)
#define DMA_DEBUG_PRINTF 0

#if DMA_DEBUG_PRINTF
#define dma_printf(...) printf(__VA_ARGS__)
#else
#define dma_printf(...) ((void)0)
#endif

#define SASI_SECTOR_SIZE 512

// Stored board_registers program offset for reset_register_pio_sm()
static int board_reg_program_offset = -1;

void dma_set_board_reg_program_offset(int offset) {
    board_reg_program_offset = offset;
}

// Safely restart the register PIO SM: disable, clear FIFOs, release
// XACK/EXTIO pindirs via NOP exec, restart SM at wrap_target, re-enable.
void reset_register_pio_sm(void) {
    pio_sm_set_enabled(PIO_REGISTERS, REG_SM_CONTROL, false);
    pio_sm_clear_fifos(PIO_REGISTERS, REG_SM_CONTROL);

    // Release XACK/EXTIO pindirs by executing a NOP with no side-set.
    // If the SM was mid-cycle with side S_XACK asserted, the frozen pindirs
    // would hold XACK low -> READY low -> DMA PIO hangs at wait READY.
    pio_sm_exec(PIO_REGISTERS, REG_SM_CONTROL, pio_encode_nop());

    // Restart SM at wrap_target for a clean T0 entry
    pio_sm_restart(PIO_REGISTERS, REG_SM_CONTROL);
    if (board_reg_program_offset >= 0) {
        pio_sm_exec(PIO_REGISTERS, REG_SM_CONTROL,
                    pio_encode_jmp(board_registers_wrap_target + board_reg_program_offset));
    }
    pio_sm_set_enabled(PIO_REGISTERS, REG_SM_CONTROL, true);

    // Reset xack_twice-specific bookkeeping
    fifo_pending_prefetch = 0;
}

void debug_dump_pin(uint pin) {
    uint32_t ctrl   = iobank0_hw->io[pin].ctrl;    // contains FUNCSEL, INOVER, OEOVER, OUTOVER
    uint32_t status = iobank0_hw->io[pin].status;  // effective OE/OUT, input sample, etc.
    uint32_t pad    = padsbank0_hw->io[pin];       // IE, PUE, PDE, DRIVE, SCHMITT, SLEWFAST
    printf("GPIO%u: CTRL=%08x STATUS=%08x PADREG=%08x\n", pin, ctrl, status, pad);
}

void pio_debug_state() {
    for (uint pin = BD0_PIN; pin < BD0_PIN + DATA_SIZE; ++pin) {
        uint32_t status = io_bank0_hw->io[pin].status;
        bool oe = status & IO_BANK0_GPIO0_STATUS_OETOPAD_BITS;
        bool out_level = status & IO_BANK0_GPIO0_STATUS_OUTTOPAD_BITS;
        bool pad_level = status & IO_BANK0_GPIO0_STATUS_INFROMPAD_BITS;
        printf("GPIO%u state: OE=%d OUT=%d PAD=%d ",
               pin,
               oe ? 1 : 0,
               out_level ? 1 : 0,
               pad_level ? 1 : 0);
    
        gpio_function_t func = gpio_get_function(pin);
        bool pull_up = gpio_is_pulled_up(pin);
        bool pull_down = gpio_is_pulled_down(pin);
        const char *pull_desc = (!pull_up && !pull_down) ? "off" :
                                (pull_up && !pull_down) ? "pull-up" :
                                (!pull_up && pull_down) ? "pull-down" :
                                                          "both";
        printf("function=%u, pulls=%s\n",
               func,
               pull_desc);
    }
}

static inline uint32_t sasi_dma_sector_count(const dma_registers_t *dma) {
    return dma ? dma->block_count.full : 0;
}

static inline uint32_t sasi_dma_bytes_requested(const dma_registers_t *dma) {
    return sasi_dma_sector_count(dma) * SASI_SECTOR_SIZE;
}

/* NOTE(Phase B): sasi_dma_device_to_ram / sasi_dma_ram_to_device back the
 * legacy PIO-driven DMA path (dma_handle_sasi_req), which is NOT on the active
 * command flow -- sasi.c drives every read/write through the storage_* layer.
 * They used to call fujinet_read_sector/write_sector directly; Phase A removed
 * that bypass (pico_fujinet/spi.c is gone), so they now have no backend. If this
 * path is ever revived, wire storage_read_sector()/storage_write_sector() (or the
 * Phase B FujiNet vtable) in here instead of the deleted direct calls. */
static bool sasi_dma_device_to_ram(dma_registers_t *dma) {
    (void)dma;
    return false;   /* no backend on the legacy DMA path since Phase A */
}

static bool sasi_dma_ram_to_device(dma_registers_t *dma) {
    (void)dma;
    return false;   /* no backend on the legacy DMA path since Phase A */
}

// Global DMA registers in scratch_x RAM bank — zero-initialized by CRT0.
// scratch_x is ideal because Core 1 (the ISR consumer) gets contention-free access.
dma_registers_t dma_registers __scratch_x("dma_registers");

void debug_pio_state(PIO pio, uint sm) {
    // Check FIFO levels
    printf("pio: %d sm: %d RX FIFO: %d/4 ", pio, sm, pio_sm_get_rx_fifo_level(pio, sm));

    // Check if the state machine is enabled
    printf("SM stalled: %d  ", pio_sm_is_exec_stalled(pio, sm));
    
    // Check program counter
    printf("PC: 0x%x  ", pio_sm_get_pc(pio, sm));

    printf("IRQ 0: %d ", pio_interrupt_get(pio, 0));
    printf("IRQ 1: %d ", pio_interrupt_get(pio, 1));
    printf("IRQ 2: %d   ", pio_interrupt_get(pio, 2));
    printf("IRQ 3: %d   ", pio_interrupt_get(pio, 3));
    
    // Check stall status
    printf("rx empty: %d \n", pio_sm_is_rx_fifo_empty(pio, sm));

}

static inline bool wait_for_pin_level(uint pin, bool level, absolute_time_t deadline) {
    while ((gpio_get(pin) != 0) != level) {
        if (absolute_time_diff_us(get_absolute_time(), deadline) <= 0) {
            return false;
        }
        tight_loop_contents();
    }
    return true;
}

static inline bool wait_for_clock5_rising_edge(void) {
    absolute_time_t deadline = make_timeout_time_us(DMA_TIMEOUT_US);
    return wait_for_pin_level(CLOCK_5_PIN, false, deadline) &&
           wait_for_pin_level(CLOCK_5_PIN, true, deadline);
}

static inline bool wait_for_hlda_assert(void) {
    return wait_for_pin_level(HLDA_PIN, true, make_timeout_time_us(DMA_TIMEOUT_US));
}

static inline bool wait_for_hlda_release(void) {
    return wait_for_pin_level(HLDA_PIN, false, make_timeout_time_us(DMA_TIMEOUT_US));
}

static inline void drive_pin_sio(uint pin, bool level) {
    // Preload SIO output state before switching the pin mux away from PIO.
    // That avoids a brief float window in SIO-input mode during handoff.
    gpio_put(pin, level ? 1 : 0);
    gpio_set_dir(pin, GPIO_OUT);
    gpio_set_function(pin, GPIO_FUNC_SIO);
}


void print_segment_offset(uint32_t addr) {
    // Assumes addr < 1MB.
    uint16_t seg = addr >> 4;
    uint16_t off = addr & 0xF;
    printf(" %04X:%04X\n", seg, off);
}

void dma_write_register(dma_registers_t *dma, dma_reg_offsets_t offset, uint8_t value) {
    //printf("dma_write_register offset (0x%x), value: 0x%02x\n", offset, value);
    // Lower address bits are ignored (based on MAME implementation)
    if (offset >= 0x80) {
        offset &= ~0x1f;
    } else {
        offset &= ~0xf;
    }

    switch (offset) {
        case REG_CONTROL: // 0x00 - Control register
        {
            uint8_t prev_control = dma->control;
            bool prev_sel = (prev_control & DMA_SELECT_BIT) != 0;
            dma->control = value;

            // RESET is a pulse - trigger only on rising edge and auto-clear
            if ((value & DMA_RESET_BIT) && !(prev_control & DMA_RESET_BIT)) {
                // Handle reset
                dma_device_reset(dma);
                dma->control &= ~DMA_RESET_BIT;
                value &= ~DMA_RESET_BIT;
            }

            // Handle DMA enable with latch mechanism 
            if (value & DMA_ON_LATCH_BIT) {
                dma->state.dma_enabled = (value & DMA_ON_VALUE_BIT);
            }
            
            // Set write mode (1 = write to memory, 0 = read from memory)
            dma->state.dma_dir_in = (value & DMA_WR_MODE_BIT);
            
            // Handle target selection transitions
            bool now_sel = (value & DMA_SELECT_BIT) != 0;
            if (now_sel && !prev_sel) {
                // Assert SEL
                dma->bus_ctrl |= SASI_SEL_BIT;
                dma_printf("SASI SEL asserted\n");
                // Latch target ID from last data bus value (SASI selection byte is a bit mask)
                dma->selected_target = sasi_extract_target_id(dma->command);
                // Target responds busy after selection (matches log: status 0x04)
                dma->bus_ctrl |= SASI_BSY_BIT;
            } else if (!now_sel && prev_sel) {
                // Deassert SEL and request first command byte (BSY|REQ|CTL)
                dma->bus_ctrl &= ~SASI_SEL_BIT;
                dma->bus_ctrl |= (SASI_BSY_BIT | SASI_REQ_BIT | SASI_CTL_BIT);
                dma->bus_ctrl &= ~SASI_INP_BIT; // host -> device
                dma->state.non_dma_req = 1;
                dma_update_interrupts(dma, true);
            }
            // Sync cached status after any bus_ctrl changes from SELECT edges
            cached_status_sync_from_bus(dma);
            break;
        }

        case REG_DATA: // 0x10 - Data register
            dma->command = value; // Store last written data value

            // If writing DATA while SELECT is asserted, treat byte as target ID (bit mask format)
            if (dma->control & DMA_SELECT_BIT) {
                dma->selected_target = sasi_extract_target_id(value);
                // Workaround like MAME: ensure SEL isn't asserted during data bus change
                dma->bus_ctrl &= ~SASI_SEL_BIT;
                dma->control &= ~DMA_SELECT_BIT;
                // Initiate command phase request immediately when selection completes via data write
                // Mirrors behavior when control write deasserts SELECT
                dma->bus_ctrl |= (SASI_BSY_BIT | SASI_REQ_BIT | SASI_CTL_BIT);
                dma->bus_ctrl &= ~SASI_INP_BIT; // host -> device
                dma->state.non_dma_req = 1;
                dma_update_interrupts(dma, true);
            }

            bool pending_non_dma = dma->state.non_dma_req;
            bool host_to_device_phase = !(dma->bus_ctrl & SASI_INP_BIT);

            // Ack host->device non-DMA cycles (command/message out) before parsing the byte
            if (pending_non_dma && host_to_device_phase) {
                dma->state.non_dma_req = 0;
                dma->state.asserting_ack = 1;
                dma->bus_ctrl |= SASI_ACK_BIT;
            }

            // During command phase (CTL asserted and REQ expected), route byte to parser
            if (dma->bus_ctrl & SASI_CTL_BIT) {
                handle_sasi_command_byte(dma, value);
            }
            // Sync cached status after any bus_ctrl changes from DATA writes
            cached_status_sync_from_bus(dma);
            break;

        case REG_STATUS: // 0x20 - Status register
            // Status register is read-only; host writes are ignored
            break;

        case REG_ADDR_L: // 0x80 - DMA address low byte
            dma->dma_address.full = (dma->dma_address.full & ~0xFF) | value;
            break;

        case REG_ADDR_M: // 0xA0 - DMA address middle byte
            dma->dma_address.full = (dma->dma_address.full & ~0xFF00) | (value << 8);
            break;

        case REG_ADDR_H: // 0xC0 - DMA address high byte (4 bits only)
            dma->dma_address.full = (dma->dma_address.full & ~0x0F0000) | ((value & 0x0F) << 16);
            break;

        default:
            printf("Write to unknown register offset (0x%x), value: 0x%02x\n", offset, value);
            break;
    }
}

uint8_t dma_read_register(dma_registers_t *dma, dma_reg_offsets_t offset) {
    uint8_t orig_offset = offset;
    // Lower address bits are ignored (based on MAME implementation)
    if (offset >= 0x80) {
        offset &= ~0x1f;
    } else {
        offset &= ~0xf;
    }

    uint8_t data = 0xff;

    switch (offset) {
        case REG_CONTROL: // 0x00 - Control register (write-only)
            // Write-only register, return 0xFF
            break;

        case REG_DATA: // 0x10 - Data register (non-DMA control/status transfers)
            if (dma->state.non_dma_req) {
                // If in message phase, return 0x00 then release bus
                if (dma->bus_ctrl & SASI_MSG_BIT) {
                    data = 0x00; // Command Complete
                    dma->state.non_dma_req = 0;
                    // Drop REQ then release bus to idle
                    dma->bus_ctrl &= ~SASI_REQ_BIT;
                    dma->bus_ctrl &= ~(SASI_CTL_BIT | SASI_INP_BIT | SASI_MSG_BIT | SASI_ACK_BIT);
                    dma->bus_ctrl &= ~SASI_BSY_BIT;
                    dma_update_interrupts(dma, false);
                }
                // If in status phase, return status then move to message phase
                else if ((dma->bus_ctrl & (SASI_CTL_BIT | SASI_INP_BIT)) == (SASI_CTL_BIT | SASI_INP_BIT)) {
                    data = dma->status; // e.g. 0x00 (GOOD)
                    // Remain asserting BSY and CTL/INP, switch to MSG and REQ for message-in
                    dma->bus_ctrl |= (SASI_MSG_BIT | SASI_REQ_BIT);
                    dma->state.non_dma_req = 1; // next read will fetch message byte
                    dma_update_interrupts(dma, true);
                } else {
                    // Unexpected non-DMA read, just return last data value
                    data = dma->command;
                    dma->state.non_dma_req = 0;
                }
            }
            break;

        case REG_STATUS:
        case 0x30: // Treat 0x30 as status alias
            // For status register reads, construct from bus control state
            data = ((dma->bus_ctrl & SASI_INP_BIT) ? SASI_INP_BIT : 0) |
                   ((dma->bus_ctrl & SASI_CTL_BIT) ? SASI_CTL_BIT : 0) |
                   ((dma->bus_ctrl & SASI_BSY_BIT) ? SASI_BSY_BIT : 0) |
                   ((dma->bus_ctrl & SASI_REQ_BIT) ? SASI_REQ_BIT : 0) |
                   ((dma->bus_ctrl & SASI_MSG_BIT) ? SASI_MSG_BIT : 0);

            fast_log("returning 0x%02x (BSY:%d REQ:%d CTL:%d INP:%d MSG:%d)\n", 
                   data, 
                   !!(dma->bus_ctrl & SASI_BSY_BIT),
                   !!(dma->bus_ctrl & SASI_REQ_BIT), 
                   !!(dma->bus_ctrl & SASI_CTL_BIT),
                   !!(dma->bus_ctrl & SASI_INP_BIT),
                   !!(dma->bus_ctrl & SASI_MSG_BIT));

            // Clear interrupt on status read
            dma_update_interrupts(dma, false);
            break;

        case REG_ADDR_L: // 0x80 - DMA address low byte
            data = dma->dma_address.full & 0xFF;
            break;

        case REG_ADDR_M: // 0xA0 - DMA address middle byte
            data = (dma->dma_address.full >> 8) & 0xFF;
            break;

        case REG_ADDR_H: // 0xC0 - DMA address high byte (4 bits only)
            data = (dma->dma_address.full >> 16) & 0x0F;
            break;

        default:
            fast_log("Read from unknown register offset (0x%x)\n", offset);
            break;
    }
    fast_log("dma_read_register offset (0x%x) returning 0x%02x\n", offset, data);
    return data;
}

void one_time_pin_setup() {
    //setup pin basics like enable pulls and set slew rate
    for (int pin = BD0_PIN; pin <= PHASE_2_PIN; ++pin) {
        gpio_set_drive_strength(pin, GPIO_DRIVE_STRENGTH_4MA);
        gpio_set_slew_rate(pin, GPIO_SLEW_RATE_SLOW);
        gpio_pull_down(pin); // enable pull-downs
        gpio_put(pin, 0);  // by default drive low
        gpio_set_dir(pin, GPIO_IN); // default to input (hi-Z); PIO claims direction later
        
        //printf("ontime gpio_setup %d  ", pin);
    }

    // for the bus control pins, to avoid floating pins during DMA handoff to 8088
    // we need to set appropriate pull-ups or pull-downs
    // we defaulted everything to pull low above, so just need to fix the active low pins

    gpio_pull_down(ALE_PIN);  // ALE is active high, so pull-down
    gpio_set_drive_strength(ALE_PIN, GPIO_DRIVE_STRENGTH_12MA);   //ALE has a pulldown bias externally on the board, drive it higher.

    gpio_pull_up(RD_PIN);   // RD is active low, so pull-up
    gpio_pull_up(WR_PIN);   // WR is active low, so pull-up
    gpio_pull_up(DTR_PIN);  // DTR is active low, so pull-up 
    gpio_pull_up(DEN_PIN);  // DEN is active low, so pull-up
    gpio_pull_up(SSO_PIN);  // SSO is active low, so pull-up
    gpio_pull_up(DLATCH_PIN); // DLATCH is active low, so pull-up
    gpio_pull_up(EXTIO_PIN); // EXTIO is active low, so pull-up
    gpio_pull_up(XACK_PIN);  // XACK is active low (open-drain), so pull-up

    // DMA IRQ line: drive low by default, assert when interrupts are pending.
    gpio_set_function(DMA_IRQ_PIN, GPIO_FUNC_SIO);
    gpio_put(DMA_IRQ_PIN, DMA_IRQ_DEASSERT_LEVEL);
    gpio_set_dir(DMA_IRQ_PIN, GPIO_OUT);
}

static inline void setup_pin_dma_control(uint32_t pin, bool is_output, bool preload_level) {
    gpio_set_function(pin, GPIO_FUNC_PIO0 + pio_get_index(PIO_DMA_MASTER));
    pio_gpio_init(PIO_DMA_MASTER, pin);
    pio_sm_set_pins_with_mask(PIO_DMA_MASTER, DMA_SM_CONTROL, (preload_level ? 1u : 0u) << pin, 1u << pin); // preload level
    pio_sm_set_pindirs_with_mask(PIO_DMA_MASTER, DMA_SM_CONTROL, (is_output ? 1u : 0u) << pin, 1u << pin); // direction
}

static inline void setup_pins_dma_control() {
    uint function = GPIO_FUNC_PIO0 + pio_get_index(PIO_DMA_MASTER);

    // ================================================================
    // Bus pin settlement: drive control signals safe BEFORE address bus.
    //
    // The original DMA card had pull-ups R2/R3/R4 on RD/, WR/, DT/R/
    // and a pull-down on ALE to prevent floating during bus exchange
    // (Victor 9000 Hard Disk Subsystem manual, §2.1.3.3).  Our Pico
    // board replaces the DMA card, so those pull-ups don't exist.
    // Without explicit ordering, there's a window where the address bus
    // is driven (to 0x00000) while RD/, WR/, ALE float — a spurious
    // write to the interrupt vector table.
    //
    // Strategy: pre-configure PIO1's output registers and pindirs for
    // control signals, then switch the pin mux.  The instant the mux
    // switches from PIO0→PIO1, control signals are immediately driven
    // to safe values with no float gap.
    // ================================================================

    // PHASE 1: Pre-configure PIO1 internal state for control signals.
    // These only touch PIO1's registers — no effect on pads yet because
    // pin functions are still PIO0.
    uint32_t ctrl_high_mask = (1u << RD_PIN) | (1u << WR_PIN) |
                              (1u << DTR_PIN) | (1u << EXTIO_PIN);
    uint32_t ctrl_out_mask  = ctrl_high_mask | (1u << ALE_PIN);

    // Output values: RD/=1, WR/=1, DTR/=1, EXTIO/=1 (inactive), ALE=0 (no latch)
    pio_sm_set_pins_with_mask(PIO_DMA_MASTER, DMA_SM_CONTROL,
                              ctrl_high_mask, ctrl_out_mask);
    // Pindirs: all control signals as OUTPUT
    pio_sm_set_pindirs_with_mask(PIO_DMA_MASTER, DMA_SM_CONTROL,
                                 ctrl_out_mask, ctrl_out_mask);

    // PHASE 2: Switch control signal pin functions to PIO1 FIRST.
    // At each gpio_set_function(), the pad instantly switches from
    // "floating (PIO0 input)" to "driven safe (PIO1 output HIGH/LOW)".
    gpio_set_function(RD_PIN, function);
    pio_gpio_init(PIO_DMA_MASTER, RD_PIN);
    gpio_set_function(WR_PIN, function);
    pio_gpio_init(PIO_DMA_MASTER, WR_PIN);
    gpio_set_function(DTR_PIN, function);
    pio_gpio_init(PIO_DMA_MASTER, DTR_PIN);
    gpio_set_function(ALE_PIN, function);
    pio_gpio_init(PIO_DMA_MASTER, ALE_PIN);
    gpio_set_function(EXTIO_PIN, function);
    pio_gpio_init(PIO_DMA_MASTER, EXTIO_PIN);

    // PHASE 3: Now safe to set up address/data pins — control signals
    // are already actively driven to safe levels.
    // Pre-load address/data output registers to 0 (address 0x00000,
    // harmless because ALE is held LOW so no address latch occurs).
    for (int pin = BD0_PIN; pin <= A19_PIN; ++pin) {
        gpio_set_function(pin, function);
        pio_gpio_init(PIO_DMA_MASTER, pin);
        pio_sm_set_pins_with_mask(PIO_DMA_MASTER, DMA_SM_CONTROL, 0u, 1u << pin);
    }

    // Address pins as outputs (safe: ALE=LOW prevents spurious latch)
    pio_sm_set_consecutive_pindirs(PIO_DMA_MASTER, DMA_SM_CONTROL,
                                   BD0_PIN, ADDRESS_BUS_SIZE, true);

    // DEN is at GPIO 40 (outside PIO's 0-31 range), use plain GPIO.
    // DEN is not needed for DMA — hold inactive (high).
    gpio_init(DEN_PIN);
    gpio_put(DEN_PIN, 1);
    gpio_set_dir(DEN_PIN, GPIO_OUT);

    // Input pins: READY, CLK5, CLK15B
    setup_pin_dma_control(READY_PIN, GPIO_IN, 0);
    setup_pin_dma_control(CLOCK_5_PIN, GPIO_IN, 0);
    setup_pin_dma_control(CLOCK_15B_PIN, GPIO_IN, 0);

    gpio_init(SSO_PIN);
    gpio_put(SSO_PIN, 0);
    gpio_set_dir(SSO_PIN, GPIO_OUT);

    gpio_init(IO_M_PIN);
    gpio_put(IO_M_PIN, 0);
    gpio_set_dir(IO_M_PIN, GPIO_OUT);

    // Explicitly release XACK by switching it to SIO/input during DMA.
    // XACK stays on PIO0 function otherwise (not in the BD0..ALE range),
    // and frozen PIO0 pindirs could hold XACK low -> READY low -> DMA hangs.
    gpio_init(XACK_PIN);
    gpio_set_dir(XACK_PIN, GPIO_IN);
}

static inline void park_dma_release_control_pins_on_sio(void) {
    // Keep the high-risk strobes actively parked while HOLD is still asserted.
    // This shrinks the float window that the external RC network has to absorb.
    drive_pin_sio(ALE_PIN, 0);
    drive_pin_sio(RD_PIN, 1);
    drive_pin_sio(WR_PIN, 1);
    drive_pin_sio(DTR_PIN, 1);
}

static inline void prepare_register_pio_handoff_locked(void) {
    uint reg_function = GPIO_FUNC_PIO0 + pio_get_index(PIO_REGISTERS);

    // Release address/data first while the critical strobes stay parked on SIO.
    pio_sm_set_consecutive_pindirs(PIO_DMA_MASTER, DMA_SM_CONTROL,
                                   BD0_PIN, ADDRESS_BUS_SIZE, false);

    for (int pin = BD0_PIN; pin <= A19_PIN; ++pin) {
        gpio_set_function(pin, reg_function);
    }

    // Restore the rest of the register-bus pins now.  ALE/RD/WR/DT/R stay on
    // SIO until HLDA drops so they never float during the hand-back.
    for (int pin = XACK_PIN; pin <= CLOCK_15B_PIN; ++pin) {
        if (pin == HOLD_PIN || pin == HLDA_PIN) {
            continue;
        }
        gpio_set_function(pin, reg_function);
    }

    // Release IO/M so the CPU can drive it during normal register cycles.
    gpio_set_function(IO_M_PIN, GPIO_FUNC_SIO);
    gpio_set_dir(IO_M_PIN, GPIO_IN);
}

static inline void finish_register_pio_handoff_locked(void) {
    uint reg_function = GPIO_FUNC_PIO0 + pio_get_index(PIO_REGISTERS);

    // Return the CPU strobes to the register listener while HOLD is still
    // asserted.  Driving them with SIO all the way until HLDA falls can fight
    // the 8088's first resumed bus cycle.
    gpio_set_function(ALE_PIN, reg_function);
    gpio_set_function(RD_PIN, reg_function);
    gpio_set_function(WR_PIN, reg_function);
    gpio_set_function(DTR_PIN, reg_function);
}

static inline void restore_register_bus_after_dma(const char *context) {
    // Move the noisy control pins off PIO1 and park them at safe levels before
    // touching the DMA SM.  HOLD remains asserted throughout this phase.
    park_dma_release_control_pins_on_sio();

    gpio_set_dir(ALE_PIN, GPIO_OUT);
    gpio_put(ALE_PIN, 0);

    pio_sm_set_enabled(PIO_DMA_MASTER, DMA_SM_CONTROL, false);
    pio_sm_clear_fifos(PIO_DMA_MASTER, DMA_SM_CONTROL);

    prepare_register_pio_handoff_locked();

    if (!wait_for_clock5_rising_edge()) {
        fast_log("%s: CLK5 sync TIMEOUT during bus release\n", context);
    }

    finish_register_pio_handoff_locked();

    uint32_t padoe_before_reset = PIO_REGISTERS->dbg_padoe;
    uint32_t padout_before_reset = PIO_REGISTERS->dbg_padout;
    reset_register_pio_sm();

    if (padoe_before_reset != 0) {
        fast_log("%s: PIO0 padoe=0x%08x padout=0x%08x before SM reset\n",
                 context, padoe_before_reset, padout_before_reset);
    }

    // HOLD/ is open-drain on the Victor side, so releasing direction is the
    // safe equivalent of deasserting it high.
    gpio_set_dir(HOLD_PIN, GPIO_IN);

    if (!wait_for_hlda_release()) {
        fast_log("%s: HLDA release TIMEOUT after HOLD release\n", context);
    }
    //turn off constant current sink for ALE
    gpio_set_dir(ALE_PIN, GPIO_IN);
}


// Timeout for individual PIO blocking operations (per bus cycle, not per sector).
// Keep this above normal wait-state variance to avoid false timeout aborts on
// long boot-time reads, but still bounded to recover from a genuinely stuck SM.
#define PIO_OP_TIMEOUT_US 15000

// Shorter timeout for FIFO drain after the last batch entry.  The FIFO
// empties within microseconds when PIO is running; this is a safety net.
#define PIO_DRAIN_TIMEOUT_US 25000

// Timeout-protected pio_sm_put.  Returns false if the TX FIFO didn't drain
// within PIO_OP_TIMEOUT_US (PIO SM is stuck).
static inline bool pio_sm_put_timeout(PIO pio, uint sm, uint32_t data) {
    absolute_time_t deadline = make_timeout_time_us(PIO_OP_TIMEOUT_US);
    while (pio_sm_is_tx_fifo_full(pio, sm)) {
        if (absolute_time_diff_us(get_absolute_time(), deadline) <= 0) {
            return false;
        }
        tight_loop_contents();
    }
    pio_sm_put(pio, sm, data);
    return true;
}

// Timeout-protected pio_sm_get.  Returns false if no data appeared in the
// RX FIFO within PIO_OP_TIMEOUT_US.
static inline bool pio_sm_get_timeout(PIO pio, uint sm, uint32_t *out) {
    absolute_time_t deadline = make_timeout_time_us(PIO_OP_TIMEOUT_US);
    while (pio_sm_is_rx_fifo_empty(pio, sm)) {
        if (absolute_time_diff_us(get_absolute_time(), deadline) <= 0) {
            return false;
        }
        tight_loop_contents();
    }
    *out = pio_sm_get(pio, sm);
    return true;
}

// DMA error codes for sasi_log_dma_error()
#define DMA_ERR_MASTER_FAIL  0xF0  // Failed to obtain DMA bus master (clock/HLDA timeout)
#define DMA_ERR_PIO_TIMEOUT  0xF1  // PIO SM stuck during DMA transfer

// Emergency abort: force-release DMA master and clean up PIO state.
// Called when a PIO timeout is detected so Core 1 can recover.
static void abort_dma_transfer(void) {
    sasi_log_dma_error(DMA_ERR_PIO_TIMEOUT,
                       dma_registers.dma_address.full,
                       dma_registers.bus_ctrl);

    restore_register_bus_after_dma("DMA abort");
}

static inline bool obtain_dma_master() {
    // Sync to CLOCK_5 edge to help avoid meta-stability around bus ownership.
    if (!wait_for_clock5_rising_edge()) {
        return false;
    }

    gpio_init(HOLD_PIN);
    gpio_put(HOLD_PIN, 0);  // sink the line, HOLD/ is open drain on Victor
    gpio_set_dir(HOLD_PIN, GPIO_OUT); // set as output to assert HOLD/
    gpio_init(HLDA_PIN);
    gpio_set_dir(HLDA_PIN, GPIO_IN);

    if (!wait_for_hlda_assert()) {
        gpio_set_dir(HOLD_PIN, GPIO_IN); // release HOLD on timeout
        return false;
    }

    return true;
}

static inline bool start_dma_control() {
    uint64_t t0_obtain = time_us_64();
    if (!obtain_dma_master()) {
        sasi_log_dma_error(DMA_ERR_MASTER_FAIL,
                           dma_registers.dma_address.full,
                           dma_registers.bus_ctrl);
        return false;
    }
    uint32_t obtain_elapsed = (uint32_t)(time_us_64() - t0_obtain);
    sasi_op_record(obtain_elapsed, &sasi_op_timing.max_obtain_us,
                   SASI_OP_OBTAIN, dma_registers.dma_address.full >> 9);
    // Release XACK/EXTIO pindirs before disabling register SM.
    // If the SM is mid-cycle with side S_XACK asserted, the frozen pindirs
    // would hold XACK low -> READY low -> DMA PIO hangs at wait READY.
    pio_sm_exec(PIO_REGISTERS, REG_SM_CONTROL, pio_encode_nop());

    // Quiesce register SM before taking bus
    pio_sm_set_enabled(PIO_REGISTERS, REG_SM_CONTROL, false);
    pio_sm_clear_fifos(PIO_REGISTERS, REG_SM_CONTROL);

    //setup all the pins to be controlled by PIO DMA SM
    setup_pins_dma_control();
    pio_sm_clear_fifos(PIO_DMA_MASTER, DMA_SM_CONTROL);
    pio_sm_set_enabled(PIO_DMA_MASTER, DMA_SM_CONTROL, true);
    return true;
}


static inline void release_dma_master() {
    restore_register_bus_after_dma("DMA release");
}


#ifndef UNIT_TEST
// Write function using two-word FIFO protocol:
//  Word 1: bits 0=W/R flag (1=write), bits 1-20=address A0-A19
//  Word 2: bits 0-7=data byte, bits 8-19=address A8-A19 (MSB)
bool dma_write_to_victor_ram(uint8_t *data, size_t length, uint32_t start_address) {
#if DMA_DEBUG_PRINTF
    dma_printf("DMA WR ");
    print_segment_offset(start_address);
#endif

    if (!data) {
        return false;
    }

    if (length == 0) {
        return true;
    }

    // debug_pio_state(PIO_DMA_MASTER, DMA_SM_CONTROL);

    // Use ceiling division to get correct batch count.
    uint32_t full_batch_count = (length + (DMA_BATCH_SIZE - 1)) / DMA_BATCH_SIZE;

    for (uint32_t batch = 0; batch < full_batch_count; batch++) {
        if (!start_dma_control()) {
            return false;
        }

        bool pio_stuck = false;
        for (size_t i = 0; i < DMA_BATCH_SIZE; i++) {
            size_t index = (batch * DMA_BATCH_SIZE) + i;
            if (index >= length) {
                break; // Never access/write beyond requested length
            }

            uint32_t addr = (start_address + index) & 0xFFFFF;  // 20-bit address
            uint8_t byte = data[index];                          // Data byte to write

            // Send two FIFO payloads per memory address =  the PIO protocol
            uint32_t fifo_t1 = ((addr & 0xFFFFFu) << 1) | 1;                // T1: [20 bit address][1-bit write=1 flag in LSB]
            if (!pio_sm_put_timeout(PIO_DMA_MASTER, DMA_SM_CONTROL, fifo_t1)) {
                pio_stuck = true;
                break;
            }

            uint32_t fifo_t2 = (addr & 0xFFF00u) | byte;                    // T2: [12 bits address A19-A8][8 bits data byte]
            if (!pio_sm_put_timeout(PIO_DMA_MASTER, DMA_SM_CONTROL, fifo_t2)) {
                pio_stuck = true;
                break;
            }
        }

        if (pio_stuck) {
            abort_dma_transfer();
            return false;
        }

        // Wait for TX FIFO to empty before releasing DMA master
        absolute_time_t drain_deadline = make_timeout_time_us(PIO_DRAIN_TIMEOUT_US);
        while (pio_sm_get_tx_fifo_level(PIO_DMA_MASTER, DMA_SM_CONTROL) > 0) {
            if (absolute_time_diff_us(get_absolute_time(), drain_deadline) <= 0) {
                abort_dma_transfer();
                return false;
            }
            tight_loop_contents();
        }
        sleep_us(3); // small delay to ensure last data is processed

        release_dma_master();

        // give 8088 time to work background interrupts like serial port or other I/O before resuming DMA
        sleep_us(DMA_SHARE_WAIT_US);
    }

    return true;
}

// Read function (PIO-based) using two-word FIFO protocol:
//  Word 1: bits 0=W/R flag (0=read), bits 1-20=address A0-A19
//  Word 2: pindirs control value 0xFFF00 (A8-A19 outputs, BD0-BD7 inputs)
bool dma_read_from_victor_ram(uint8_t *data, size_t length, uint32_t start_address) {

#if DMA_DEBUG_PRINTF
    dma_printf("DMA RD Length: %zu, start_address: %d ", length, start_address);
    print_segment_offset(start_address);
#endif

    if (!data) {
        return false;
    }

    if (length == 0) {
        return true;
    }

#if DMA_DEBUG_PRINTF
    debug_pio_state(PIO_DMA_MASTER, DMA_SM_CONTROL);
#endif

    // Use ceiling division to get correct batch count.
    uint32_t full_batch_count = (length + (DMA_BATCH_SIZE - 1)) / DMA_BATCH_SIZE;

    for (uint32_t batch = 0; batch < full_batch_count; batch++) {
        if (!start_dma_control()) {
            return false;
        }

        bool pio_stuck = false;
        for (size_t i = 0; i < DMA_BATCH_SIZE; i++) {
            size_t index = (batch * DMA_BATCH_SIZE) + i;
            if (index >= length) {
                break; // Never access/read beyond requested length
            }

            uint32_t addr = (start_address + index) & 0xFFFFF;  // 20-bit address

            // Send two FIFO words per the PIO protocol
            uint32_t fifo_t1 = ((addr & 0xFFFFFu) << 1) | 0; // T1: [20 bit address][1-bit read=0 flag in LSB]
            if (!pio_sm_put_timeout(PIO_DMA_MASTER, DMA_SM_CONTROL, fifo_t1)) {
                pio_stuck = true;
                break;
            }

            uint32_t fifo_t2 = 0xFFF00; // pindirs value only, no data or address T2: [A8-A19 remain outputs][BD0-BD7 inputs]
            if (!pio_sm_put_timeout(PIO_DMA_MASTER, DMA_SM_CONTROL, fifo_t2)) {
                pio_stuck = true;
                break;
            }

            // Get the data byte that was read
            uint32_t char_data;
            if (!pio_sm_get_timeout(PIO_DMA_MASTER, DMA_SM_CONTROL, &char_data)) {
                pio_stuck = true;
                break;
            }
            data[index] = char_data & 0xFF;
        }

        if (pio_stuck) {
            abort_dma_transfer();
            return false;
        }

        // Wait for all responses to be received before releasing DMA master
        absolute_time_t drain_deadline = make_timeout_time_us(PIO_DRAIN_TIMEOUT_US);
        while (pio_sm_get_rx_fifo_level(PIO_DMA_MASTER, DMA_SM_CONTROL) > 0) {
            if (absolute_time_diff_us(get_absolute_time(), drain_deadline) <= 0) {
                abort_dma_transfer();
                return false;
            }
            tight_loop_contents();
        }
        sleep_us(3); // small delay to ensure all data is processed

        release_dma_master();

        // give 8088 time to work background interrupts like serial port or other I/O before resuming DMA
        sleep_us(DMA_SHARE_WAIT_US);
    }

    return true;
}

#if VERIFY_DMA_WRITES
dma_verify_stats_t dma_verify_stats;

int dma_verify_victor_ram(uint32_t victor_addr, const uint8_t *expected, uint32_t len, uint32_t lba) {
    uint8_t readback[512];
    if (len > sizeof(readback)) len = sizeof(readback);

    if (!dma_read_from_victor_ram(readback, len, victor_addr)) {
        dma_verify_stats.sectors_checked++;
        dma_verify_stats.sectors_failed++;
        return -1;
    }

    int mismatches = 0;
    for (uint32_t i = 0; i < len; i++) {
        if (readback[i] != expected[i]) {
            mismatches++;
            dma_verify_stats.total_byte_mismatches++;

            if (!dma_verify_stats.first_error_recorded) {
                dma_verify_stats.first_error_recorded = true;
                dma_verify_stats.first_err_lba = lba;
                dma_verify_stats.first_err_addr = (victor_addr + i) & 0xFFFFF;
                dma_verify_stats.first_err_offset = (uint16_t)i;
                dma_verify_stats.first_err_expected = expected[i];
                dma_verify_stats.first_err_actual = readback[i];
            }
        }
    }

    dma_verify_stats.sectors_checked++;
    if (mismatches > 0) {
        dma_verify_stats.sectors_failed++;
    }

    return mismatches;
}
#endif // VERIFY_DMA_WRITES

#else
// Unit-test in-memory Victor RAM model (64 KiB to fit SRAM)
static uint8_t test_victor_ram[1 << 16];
static const size_t TEST_VICTOR_RAM_SIZE = (1 << 16);

bool dma_write_to_victor_ram(uint8_t *data, size_t length, uint32_t start_address) {
    if (!data) {
        return false;
    }
    for (size_t i = 0; i < length; i++) {
        uint32_t addr = (start_address + i) & 0xFFFFF;
        if (addr < TEST_VICTOR_RAM_SIZE) test_victor_ram[addr] = data[i];
    }
    return true;
}

bool dma_read_from_victor_ram(uint8_t *data, size_t length, uint32_t start_address) {
    if (!data) {
        return false;
    }
    for (size_t i = 0; i < length; i++) {
        uint32_t addr = (start_address + i) & 0xFFFFF;
        data[i] = (addr < TEST_VICTOR_RAM_SIZE) ? test_victor_ram[addr] : 0x00;
    }
    return true;
}

uint8_t* test_get_victor_ram() { return test_victor_ram; }
size_t test_get_victor_ram_size() { return TEST_VICTOR_RAM_SIZE; }
#endif

// Device reset function (based on MAME implementation)
//
// IMPORTANT: This function is called by the Core 1 deferred worker when it
// processes a RESET entry from the defer queue.  The ISR runs on the SAME
// core (Core 1) as the defer worker, so bus_ctrl is only modified by the
// defer worker itself (the ISR only modifies bus_ctrl during DATA-read
// status/message transitions, which can't happen during RESET processing).
//
// The ISR DOES update the cache and dma_address/control inline, so:
//   - DO NOT zero dma_address.full -- ISR updates address bytes inline
//   - DO NOT zero control -- ISR uses for SELECT edge detection
//   - DO zero bus_ctrl -- prevents stale phase bits (e.g., MSG from a
//     previous command's message phase) from corrupting subsequent SELECT
//     processing.  The defer worker will rebuild bus_ctrl correctly when
//     it processes the post-RESET SELECT entries.
//   - DO zero non_dma_req/asserting_ack -- bus protocol state must reset
//
// DO NOT zero the cache here or in the caller.  The ISR already set the
// cache correctly when it detected the RESET bit, and subsequent ISR entries
// (SELECT, deselect) updated the cache predictions further.  Zeroing the
// cache would destroy those predictions and create a window where the host
// sees bus_free status despite an active IRQ.
void dma_device_reset(dma_registers_t *dma) {
    // Clear bus protocol state -- RESET returns bus to idle
    dma->bus_ctrl = 0;
    dma->state.non_dma_req = 0;
    dma->state.asserting_ack = 0;

    // Clear command/diagnostic state
    dma->state.dma_enabled = 0;
    dma->state.dma_dir_in = 0;
    dma->state.data_out_expected = 0;
    dma->state.status_pending = 0;
    dma->command = 0;
    dma->status = 0;
    dma->selected_target = 0;
    dma->block_count.full = 0;
    dma->logical_block.full = 0;
    dma->reset_requested = false;

    // DO NOT zero these -- the ISR manages them inline:
    //   dma->dma_address.full  -- ISR updates address bytes inline
    //   dma->control           -- ISR uses for SELECT edge detection

    // Clear interrupt
    dma_update_interrupts(dma, false);
    status_phase_flag = false;  // Reset diagnostic flag on device reset

    // DO NOT call cached_status_sync_from_bus() or cached_set_data() here.
    // The ISR already set the cache correctly.  See comment block above.

    // Reset SASI command accumulator state
    sasi_reset_command_state();

    // Track reset count for diagnostics (no printf - blocks Core 1 for ~780us)
    static volatile uint32_t reset_count = 0;
    reset_count++;
}

// Update interrupt state
void dma_update_interrupts(dma_registers_t *dma, bool irq_state) {
    if (irq_state != dma->state.interrupt_pending) {
        dma->state.interrupt_pending = irq_state;
        gpio_put(DMA_IRQ_PIN, irq_state ? DMA_IRQ_ASSERT_LEVEL : DMA_IRQ_DEASSERT_LEVEL);
        // In real implementation, this would trigger actual interrupt to CPU
        //printf("DMA interrupt %s\n", irq_state ? "asserted" : "cleared");
    }
}

// Hold the Victor 8088 via HOLD/HLDA handshake without touching PIO state machines.
// Use around slow SD card I/O so the BIOS timeout counter cannot advance.
bool hold_victor_bus(void) {
    if (!wait_for_clock5_rising_edge()) {
        return false;
    }

    // Assert HOLD/ (open-drain)
    gpio_init(HOLD_PIN);
    gpio_put(HOLD_PIN, 0);
    gpio_set_dir(HOLD_PIN, GPIO_OUT);
    gpio_init(HLDA_PIN);
    gpio_set_dir(HLDA_PIN, GPIO_IN);

    if (!wait_for_hlda_assert()) {
        gpio_set_dir(HOLD_PIN, GPIO_IN);  // release on timeout
        return false;
    }
    return true;
}

// Release HOLD/ so the 8088 resumes execution.
void release_victor_bus(void) {
    gpio_set_dir(HOLD_PIN, GPIO_IN);  // float high via pull-up
}

// Handle SASI REQ signal and DMA transfers (based on MAME ctrl_change_handler)
void dma_handle_sasi_req(dma_registers_t *dma) {
    if (dma->bus_ctrl & SASI_REQ_BIT) {
        // Only data (not control or status) transfers can use DMA
        if (dma->state.dma_enabled && !(dma->bus_ctrl & SASI_CTL_BIT)) {
            bool ok = false;
            if (dma->state.dma_dir_in) {
                // Device → Victor RAM
                ok = sasi_dma_device_to_ram(dma);
                dma_printf("DMA write to RAM at 0x%06X\n", dma->dma_address.full);
            } else {
                // Victor RAM → Device
                ok = sasi_dma_ram_to_device(dma);
                dma_printf("DMA read from RAM at 0x%06X\n", dma->dma_address.full);
            }

            if (!ok) {
                dma_printf("Warning: SASI DMA transfer failed\n");
            }
            
            // Auto-increment address after each transfer (key missing piece!)
            dma->state.asserting_ack = 1;
            dma->bus_ctrl |= SASI_ACK_BIT;
        } else {
            // ACK will be generated upon direct data register access
            dma->state.non_dma_req = 1;
        }
    } else if (dma->state.asserting_ack) {
        dma->bus_ctrl &= ~SASI_ACK_BIT;
        dma->state.asserting_ack = 0;
    }
    
    // Command or status request from controller generates interrupt
    if ((dma->bus_ctrl & (SASI_REQ_BIT|SASI_CTL_BIT)) == (SASI_REQ_BIT|SASI_CTL_BIT)) {
        dma_update_interrupts(dma, true);
    }
}
