IntergalacticMicrosystems/pico_v9k/software/pico_victor/reg_queue_processor.h

/*
 * reg_queue_processor.h - Deferred processing system for DMA register operations
 *
 * This system separates the fast path (return cached values) from the slow path
 * (process state changes), allowing us to meet the 200ns timing requirement.
 */

#ifndef REG_QUEUE_PROCESSOR_H
#define REG_QUEUE_PROCESSOR_H

#include <stdint.h>
#include <stdbool.h>
#include "dma.h"

// Queue size must be power of 2 for fast masking.
#define DEFER_QUEUE_SIZE 256
#define DEFER_QUEUE_MASK (DEFER_QUEUE_SIZE - 1)

// Deferred operation entry
typedef struct {
    uint32_t raw_value;     // Original PIO payload
    uint32_t timestamp;     // Optional timestamp for debugging
} defer_entry_t;

// Deferred processing queue
typedef struct {
    defer_entry_t entries[DEFER_QUEUE_SIZE];
    volatile uint32_t head;  // Producer index (IRQ handler)
    volatile uint32_t tail;  // Consumer index (Core 1 worker)

    // Statistics for debugging
    volatile uint32_t drops;     // Count of dropped entries due to full queue
    volatile uint32_t processed; // Count of processed entries
} defer_queue_t;

// Cached register values for fast reads
// Aligned to cache line for optimal performance
// NOTE: values must be volatile - accessed by both Core 0 (fast handler) and Core 1 (deferred processor)
typedef struct {
    volatile uint8_t values[256];
    uint32_t last_update;  // Timestamp of last update
} __attribute__((aligned(64))) cached_registers_t;

// Initialize the deferred processing system
void dma_defer_init(void);

// Fast path: enqueue operation for deferred processing (called from IRQ)
static inline bool defer_enqueue_fast(defer_queue_t *queue, uint32_t raw_value) {
    uint32_t head = queue->head;
    uint32_t next = (head + 1) & DEFER_QUEUE_MASK;

    // Check if queue is full
    if (next == queue->tail) {
        queue->drops++;
        return false;
    }

    // Add entry
    queue->entries[head].raw_value = raw_value;

    // Memory barrier to ensure write completes before advancing head
    __asm volatile("dmb" ::: "memory");

    queue->head = next;
    return true;
}

// Slow path: dequeue and process operation (called from Core 1)
bool defer_dequeue(defer_queue_t *queue, defer_entry_t *entry);

// Process a deferred operation
void defer_process_entry(dma_registers_t *dma, const defer_entry_t *entry);

// Core 1 worker main loop
void defer_worker_main(void);


// Helpers to keep cached register values aligned with SASI bus state
void cached_status_sync_from_bus(const dma_registers_t *dma);
void cached_set_data(uint8_t value);
void cached_sync_dma_address(const dma_registers_t *dma);

// Update cached register value
static inline void defer_update_cached(cached_registers_t *cached, uint32_t offset, uint8_t value) {
    cached->values[offset & 0xFF] = value;
}

// Get cached register value
static inline uint8_t defer_get_cached(cached_registers_t *cached, uint32_t offset) {
    return cached->values[offset & 0xFF];
}

// Core 1 liveness heartbeat (timestamp of last defer_process_entry call)
extern volatile uint64_t defer_last_process_us;

// External cache and queue instances - place in time_critical section for fast access
extern defer_queue_t defer_queue;
extern cached_registers_t cached_regs;

// Atomically update bus_ctrl and cache to prevent ISR from serving stale phase.
// Updates cache BEFORE bus_ctrl so the ISR always sees the correct phase even
// if it preempts between the two writes (both run on Core 1).
static inline void sasi_bus_ctrl_set(dma_registers_t *dma, uint8_t new_bus_ctrl) {
    uint8_t s = new_bus_ctrl & (SASI_INP_BIT | SASI_CTL_BIT | SASI_BSY_BIT | SASI_REQ_BIT | SASI_MSG_BIT);
    cached_regs.values[REG_STATUS] = s;
    cached_regs.values[0x30] = s;
    __asm volatile("dmb" ::: "memory");
    dma->bus_ctrl = new_bus_ctrl;
    __asm volatile("dmb" ::: "memory");
}

#endif // DMA_DEFER_H
