IntergalacticMicrosystems/pico_v9k/(commit log)

2026-03-01 Add SASI command timing, RESET counter, stuck detector, and DOS INT 24h handler
    Instrumentation to diagnose intermittent Victor 9000 reboots during stress test:
    - Per-command elapsed time tracking in sasi.c (last/max/>1s/>4s counters)
    - RESET event counter in register ISR (volatile increment, no printf)
    - Core 1 defer heartbeat timestamp for liveness detection
    - Auto stuck-state detector in main loop (gated on storage_ready)
    - Enhanced 'p' UART dump with all new diagnostic counters
    - DOS hd_stress: custom INT 24h handler, unbuffered stdout, fclose checks
    [dma_board.c, reg_queue_processor.c, reg_queue_processor.h, register_irq_handlers.c, register_irq_handlers.h, sasi.c, sasi.h]
2026-03-01 Fix bus pin settlement ordering to prevent spurious memory cycles
    The original DMA card had pull-ups R2/R3/R4 on RD/, WR/, DT/R/ and a
    pull-down on ALE to prevent floating during bus exchange (Victor 9000
    Hard Disk Subsystem manual, §2.1.3.3). Our Pico board replaces the DMA
    card, so those pull-ups don't exist.
    The previous pin setup drove the address bus to 0x00000 while RD/, WR/,
    and ALE were still floating — a spurious write to the interrupt vector
    table. This happened every 128-byte DMA batch (4x per sector), creating
    tens of thousands of opportunities for glitches during stress tests.
    Fix: reorder setup_pins_dma_control() and setup_pins_register_inputs():
    Acquisition: pre-configur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
    [dma.c]
2026-03-03 Add per-op timing, HOLD/HLDA fix, stuck detector, DMA verify, HardFault handler
    Diagnostics:
    - Per-operation timing breakdown in sasi.h/sasi.c (sd_rd, sd_wr, dma_rd,
    dma_wr, sync, verify, obtain) with stall tracking (>100ms threshold)
    - HOLD/HLDA pin state and PIO1 DMA SM state added to p-dump
    - Stack canary on Core 1 (32 words, checked every 5s)
    - Stuck detector: flags when defer queue stalls while ISR keeps firing
    - Custom HardFault handler with LED blink pattern (replaces FatFS crash.c)
    - DMA write verification infrastructure (VERIFY_DMA_WRITES, CRC-8 trace ring)
    Bus fixes:
    - Skip HOLD_PIN and HLDA_PIN in setup_pins_register_inputs() PIO0 function
    switch loop — these are DMA-master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
    [dma.c, dma.h, dma_board.c, sasi.c, sasi.h]
2026-03-10 Cache-first bus_ctrl updates to eliminate ISR stale-phase races
    Replace scattered bus_ctrl mutations + cached_status_sync_from_bus() with
    atomic sasi_bus_ctrl_set() helper that writes cache BEFORE bus_ctrl, preventing
    Core 0 ISR from serving stale SASI phase when it preempts between the two
    writes. Also:
    - Prevent host DATA writes from polluting target->host DATA cache (ISR skip)
    - Add sasi_in_dma_transfer flag so Core 0 stuck detector ignores DMA windows
    - Fix dump_pio0_and_pin_state() to check SM enable bit instead of is_claimed
    - Add PIO0 pad-state diagnostics and CLK5 timeout reporting in release_dma_master
    [dma.c, dma_board.c, reg_queue_processor.c, reg_queue_processor.h, register_irq_handlers.c, sasi.c, sasi.h]
2026-04-10 Stabilize DMA bus handoff
    [dma.c, register_cache.c]
2026-04-19 added ALE pulldown circuit connected to GPIO 46.
2026-04-25 adjusted T cycle timing for faster iteration after fixing ALE circuit. set ALE drive strength to 12ma, rest of pins to 4ma.
    [dma.c]
2026-05-01 reworked PCB for latest gpio configuration. added reset connect to 8088, adjusted SIP for SD card instead of SDIO. added UART RX and SIP breakout pins.
    [Victor9K_pga2350.kicad_pcb, Victor9K_pga2350.kicad_sch]
2026-05-17 Clean up VERIFY_DMA_WRITES gating and retire debug-pin/ALE-sink scaffolding
    - Switch VERIFY_DMA_WRITES from always-defined-as-0 to a CMake option, and
    update all conditional sites from #ifdef to #if so the disabled path
    actually compiles out.
    - Remove the ALE_CURRENT_SINK_PIN (GPIO 46) drive code and DEBUG_PIN (GPIO
    47) ISR toggling now that the ALE pulldown and bus handoff are stable on
    the latest PCB; drop the related pin defs, FIFO helper masks, and SIO
    warmup touches.
    - Realign benchmark_irq.c with the current cached register FIFO decode
    path (the old dma_fast/dma_ultra_fast targets no longer exist) and
    rename collision-prone UART_* macros in test_clock_check.c /
    test_dma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
    [benchmark_irq.c, dma.c, dma.h, dma_board.c, dma_irq_handler.c, fifo_helpers.h, register_irq_handlers.c, sasi.c]
2026-06-21 Mount all discovered disk images, not just the first
    The fail-fast guard added to read_sector_from_disk() correctly stops a
    read to an unmounted/absent SASI target from blocking for the 10s SPI
    phase timeout (which blew the 5s BIOS command timeout and wedged the
    bus). With that slow fallthrough gone, the auto-mount path's existing
    limitation became visible: it only ever mounted image index 0 on
    target 0, so a second image on the SD card was never presented to the
    host as a second drive.
    Loop over every discovered image and mount each on its own successive
    SASI target (capped at STORAGE_MAX_TARGETS, with a log line when there
    are more images than target slots). Discovery order is preserved,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
    [register_cache.c, sasi.c]
2026-07-10 Apply bench-validated firmware fixes from 2026-07-09 review
    - sasi.c: keep sasi_in_dma_transfer asserted through the WRITE(6)
    storage_sync so the Core-0 stuck detector no longer false-fires
    during slow SD f_sync windows (70-110 ms observed on real cards);
    the reset-requested early return now clears the flag itself
    - sd_storage.c: sort discovered image names case-insensitively so
    SASI target assignment (and therefore the boot drive on target 0)
    is deterministic instead of following FAT directory order
    - spi.c: default SPI_DEBUG to 0 and gate the per-sector Read/Write
    success prints under it; a 512-byte hex dump per sector at 115200
    baud would blow the 5 s BIOS timeout on the Fuj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
    [dma.c, dma_board.c, sasi.c]
2026-07-10 Reconcile docs with the current tree; add .gitignore
    - CLAUDE.md: rewritten against the files that actually exist — the
    never-modify warning now guards dma_master.pio/board_registers.pio
    (dma_read_write.pio, extio_helper.pio and dma_ultra_fast.c are gone),
    UART corrected to uart0 TX=GPIO0/RX=GPIO33 @ 230400 with the console
    command list, storage described as SD-primary with FujiNet fallback,
    and the long dated status history collapsed (preserved in git history)
    - README.md: same reconciliation for the public-facing doc, plus
    build/flash instructions that match CMakeLists and current tooling
    - REVIEW_FINDINGS.md: check off applied items with dates and re-test
    status (from the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
2026-07-10 Add hardware test plan, bench tooling, and 2026-07-09 test report
    - HARDWARE_TEST_PLAN.md: phased bench validation plan (build/flash,
    boot consistency, read path, write path, multi-disk, stress, fault
    injection) with rig-verified constants and single-owner UART rules
    - test/dos_dma_test/dma_vfy2.c: bench-safe successor to dma_verify.c —
    triple-read self-consistency instead of stale baked CRCs, write test
    saves/restores LBAs 200-204 instead of clobbering them, and a new
    64K-boundary straddle test that DMAs into a buffer crossing a 64 KB
    physical line and prints the addresses as proof of the 20-bit carry
    - bench_logs/: session report (all phases pass at 040c8d5 + fixes,
    plus re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
    [diaglog.py]
2026-07-10 Add v9k_dma_rev2 hardware design (RP2350B + MCP23S17 + optional ESP32-S3)
    Stage 3 of the board_design pipeline: generated schematic + emitted PCB
    (pre-placement), DESIGN.md spec, sourced parts in project.toml, and the
    skill dogfooding log. Includes JP1/JP2 shunt jumpers that cross UART0
    (GP46/GP33) over to ESP32 TXD0/RXD0 so the RP2350 can flash the ESP32
    from an SD-card image via esp-serial-flasher (EN/IO0 already strapped
    through the expander); shunts open by default to keep J8 adapter-safe.
    [v9k_dma_rev2.kicad_pcb, v9k_dma_rev2.kicad_sch]
2026-07-11 v9k_dma_rev2: complete stages 4-6 — placed, routed (ROUTE OK), BOM finalized
    - Placement + routing via llm_autoroute (margin-1 sweep winner): 122/122 nets,
    4940mm track, 252 vias, GND pours ~60% both layers, 0 unrouted, 0 hard DRC
    (kicad-cli verified; 68 cosmetic silk items remain). R3/R4/C8 moved clear of
    the USB-C plug path per review.
    - U3 WROOM thermal vias enlarged to 0.3mm drill (board min-hole conflict);
    J3 edge-mount microSD edge-clearance exemption via v9k_dma_rev2.kicad_dru.
    - Schematic: MPN fields populated from project.toml [[parts]] (19 symbols);
    U1/GF1 excluded from BOM (own stock / PCB feature).
    - Stage 6: check-bom 0 errors, order_bom.csv $107.23 for 5 boards
    (D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
    [bom.csv, order_bom.csv, v9k_dma_rev2.kicad_pcb, v9k_dma_rev2.kicad_sch]
2026-07-11 rev2: adopt machine-readable source keys; GF1 MPN via set-part-fields
    - project.toml: source = "stock" (U1) / "pcb-feature" (GF1) per the
    PROJECT_TOML.md convention, replacing the comment-only grouping — the new
    edablock set-part-fields / lint-sch check_mpn key off it.
    - Schematic: GF1 MPN property stamped by set-part-fields (validation run of
    the new tool against this project; lint-sch exits 0).
    [v9k_dma_rev2.kicad_sch]
2026-07-14 Add rctl.sh bench wrapper; ignore bench session artifacts in subdirs
    - rctl.sh is the remote-control wrapper that boot_iter.sh already
    depends on
    - extend .gitignore so session grabs/logs in bench_logs subdirectories
    (e.g. hs_speed/) and *.out files stay untracked
    - KiCad project file picked up zone-default settings on open
2026-07-14 Add FujiNet SPI transport (Phase A) ported from v9k_flop
    Port the bench-proven ESP32-S3 FujiNet link to this board: fuji_proto
    SLIP/FujiBus core copied verbatim; fuji_blkdev transport adapted to
    SPI1 shared with the SD card (CS=GP45, DRDY=GP46, 12.5 MHz bring-up
    clock, per-transaction baud save/restore, static SRAM buffers -- no
    PSRAM here). Frame building happens under the bus mutex so core 0
    console and future core 1 storage traffic can't clobber the shared
    buffers.
    Remove the stale pico_fujinet/spi.c stub (its pin map collided with
    the SD card and DEN) and the direct fujinet_* bypasses in sasi.c /
    register_cache.c / dma.c; those paths now fail fast with Phase B
    TODOs. Add an 'F' diag-con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
    [dma.c, dma_board.c, fuji_blkdev.c, fuji_blkdev.h, fuji_proto.c, fuji_proto.h, on_device_runner.c, register_cache.c]
2026-07-14 Add FujiNet storage backend, per-target routing, and bench console (Phase B)
    Storage layer now routes per SASI target: each target records the
    backend that mounted it, so the SD boot drive and FujiNet images can
    coexist. storage_mount_on() lazy-inits backends without changing the
    primary; the SD-fail boot path falls back to FujiNet through the
    vtable.
    New fuji_storage.c implements storage_ops_t over the Phase A
    transport (init pings the ESP so an absent FujiNet fails fast; SASI
    target N maps to ESP device slot N; per-sector reads/writes,
    READ_MULTI batching deferred to a perf pass). All console-initiated
    SPI ops execute on core 1 via a single-slot mailbox serviced from
    defer_worker_main --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
    [dma_board.c, fuji_blkdev.c, fuji_blkdev.h, fuji_storage.c, fuji_storage.h, reg_queue_processor.c, register_cache.c, sasi.c]
2026-07-14 Add management console and host control channel (Stages 1a + 2)
    Console: the interactive console moves to native USB CDC running
    v9k_flop's micro_tui stack -- line REPL (frozen OK/ERR contract) plus
    a full-screen menu, unified sd:/fuji: image namespace
    (ls/status/mount/eject/peek/wifi/diag/menu), cell buffers in static
    SRAM. The Phase B fuji mailbox generalizes into console/console_ops
    (typed results; all storage/SPI stays on core 1). The single-char
    SASI debug console and F shell are removed; `diag` is the escape
    hatch and also dumps captured HardFault info. UART0 is log-only at
    115200 (was 230400). Absent-media semantics follow v9k_flop: each
    backend's commands degrade independently.
    Host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
2026-07-14 Add dmaterm.c: DOS terminal for the DMA card management console
    Near-verbatim port of viclibc2/viaterm/viaterm.c with only the
    channel moved: detection and I/O go to segment 0xEF30 offsets
    0x40/0x50/0x60 with signature 0xD0 (the CRTC, VRAM, and keyboard
    paths are unchanged -- same machine). Builds warning-free with
    OpenWatcom (build_dos.sh, DMATERM.EXE 10346 bytes).
2026-07-14 Fix first-touch XIP stall in mgmt register writes
    mgmt_chan_reg_write is called from the core-1 register ISR but lived in
    flash: the first call after boot took an XIP cache miss, stalling the
    ISR long enough for the PIO RX FIFO to back up and the register SM to
    miss the next bus access, so the host read bus float. This broke
    first-try DMATERM detection after a card power-up. Place it in RAM with
    __time_critical_func (PICO_BUILD-guarded so host tests still build with
    plain gcc). Verified over three cold-boot cycles on hardware.
    [mgmt_chan.c]
2026-07-14 Add buscap: PIO2 logic analyzer for the host bus interface
    New console command `buscap <skip> [w [expect_hex]]` captures
    XACK-framed bus accesses on GPIO0-31 via PIO2 + DMA (4096 samples):
    - Edge mode: 10 ns/sample, prints the full signal edge list (BD, RD/,
    WR/, DTR, ALE, HOLD, XACK/, EXTIO/, READY, HLDA) for one access.
    - Wide mode (w): 40 ns/sample (~164 us window), one summary line per
    access with XACK duration and the bus value at mid-pulse and at the
    RD/ latch point.
    - 32-bit skip count fed through the TX FIFO (pull-based skip loop with
    a patched jmp) to reach a specific access after the trigger.
    - expect_hex: auto-dumps the edge list for any read access whose
    latched byte d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
    [buscap.c, buscap.h, tui_cmds.c]
2026-07-15 Fix FujiNet floating-CS SD corruption and two recovery gaps
    Root cause of the intermittent no-boot/x98/missing-images failures with
    the ESP32-S3 attached: fuji_link_init() ran lazily, so from power-on
    until the first FujiNet operation GP45 (ESP CS) sat at the pad-reset
    pull-down against the ESP's internal pull-up — a mid-rail CS in the
    ESP's undefined logic band, next to the 25 MHz SD clock on the shared
    SPI1 bus. The ESP intermittently saw itself selected and drove MISO
    against the SD card, corrupting SD I/O until a fuji op finally
    configured the pin (which is why picking an image in the F4 menu
    "fixed" it).
    - core1_main: call fuji_link_init() before SD init so CS is driven
    high within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
    [fuji_blkdev.c, fuji_proto.h, register_cache.c]
2026-10-10 Add console create/copy/rm commands for SD disk images
    New console ops to manage .img files on the SD card without pulling it:
    create <file.img> <sizeMB> allocate a blank 1-512 MB image (f_expand
    with seek-extend fallback; first 64 KB zeroed
    so no stale boot sector shows through)
    copy <src> <dst> duplicate an image
    rm <file.img> delete an unmounted image
    copy runs chunked on core 1 (32 KB per service() pass, op stays PENDING
    between chunks) so SASI keeps being serviced during a multi-minute copy.
    All three refuse images that are currently mounted via FF_FS_LOCK
    (FR_LOCKED on the second open/unlink),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
2026-10-10 Fix junk chars in DMA terminal: double-read RESP, add mgmt trace rings
    Under heavy card-side load a Victor read of the mgmt RESP register can
    sample the bus mid-drive and latch address-residual bits, showing up as
    junk characters in the terminal. RESP reads are side-effect-free until
    the ack, so both clients (dmaterm.c and viaterm_dma.asm) now re-read
    RESP until two consecutive reads agree before acking. The embedded
    vtasm blob is rebuilt from the updated asm.
    Firmware side adds two diagnostic rings used to localize the tears:
    mgmt_bus_trace (ISR, one record per CMD/STATUS/RESP access, idle STATUS
    polls deduped) and mgmt_pub_trace (publish side, every byte handed to
    RESP). Both are dumped v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
